markrlupton/rt1176-micromod-som/docs/floorplan_v1.png

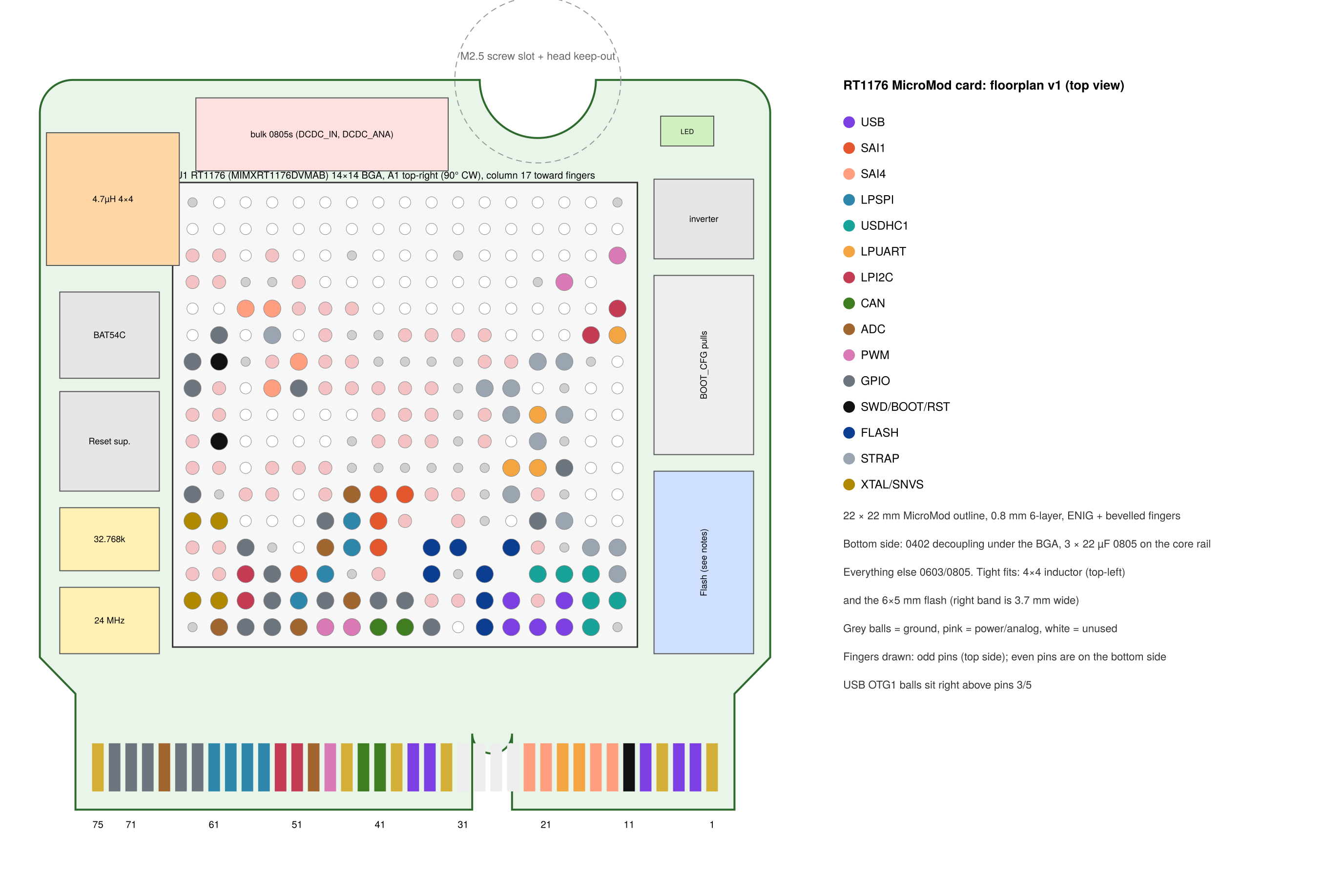
docs/floorplan_v1.png
