markrlupton/rt1176-micromod-som/docs/layout/b_cu.png

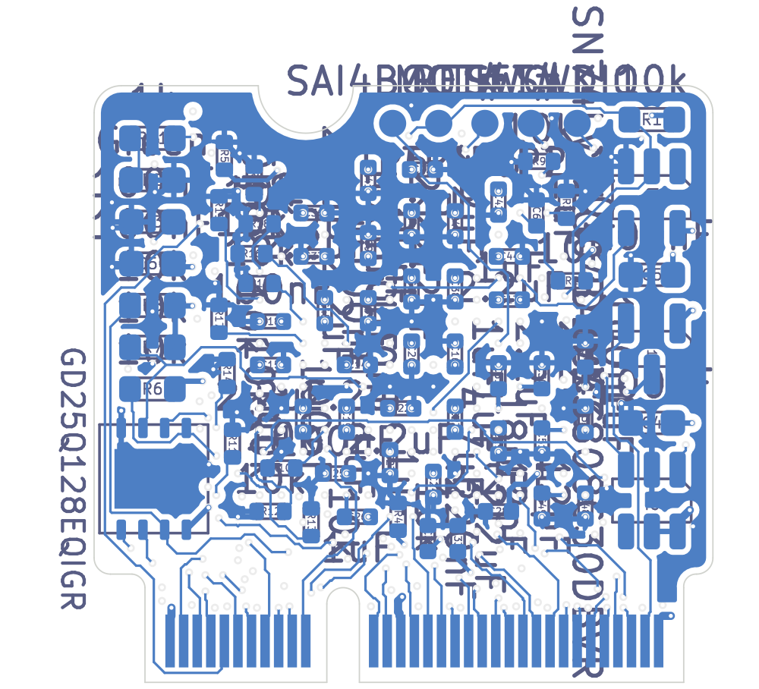
docs/layout/b_cu.png
