markrlupton/rt1176-micromod-som/docs/layout/f_cu.png

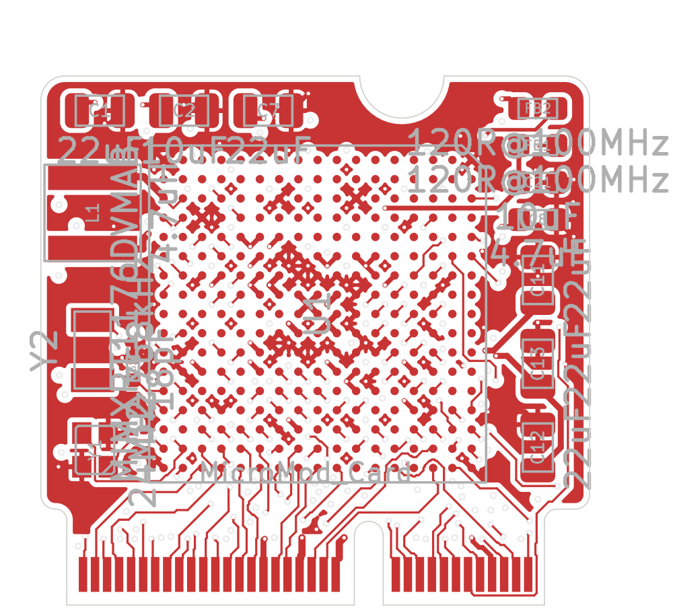
docs/layout/f_cu.png
