markrlupton/rt1176-micromod-som/docs/layout/in1_cu.png

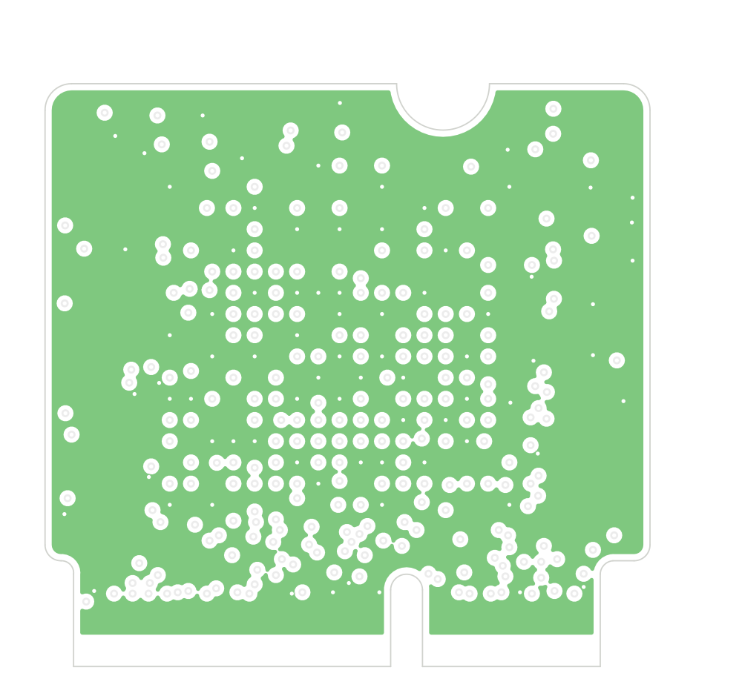
docs/layout/in1_cu.png
