markrlupton/rt1176-micromod-som/docs/layout/in2_cu.png

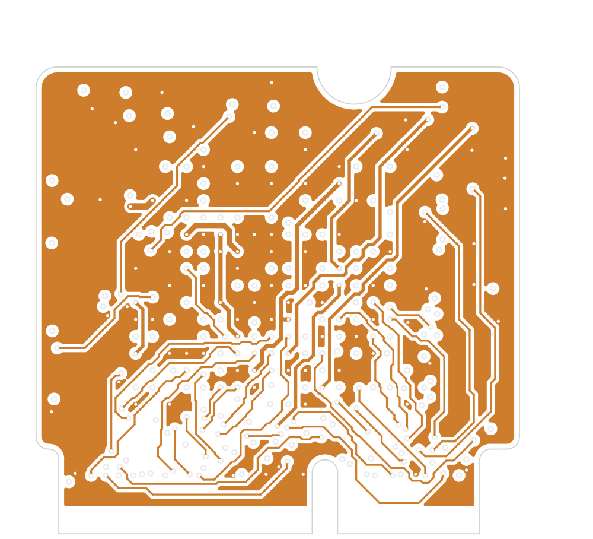
docs/layout/in2_cu.png
