markrlupton/rt1176-micromod-som/docs/layout/in3_cu.png

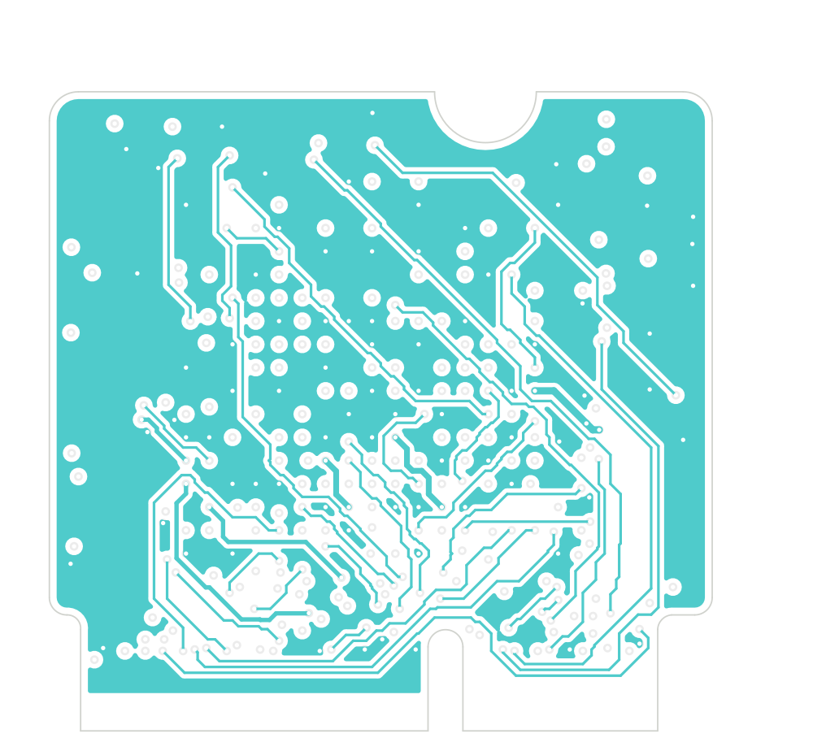
docs/layout/in3_cu.png
