markrlupton/rt1176-micromod-som/docs/layout/in4_cu.png

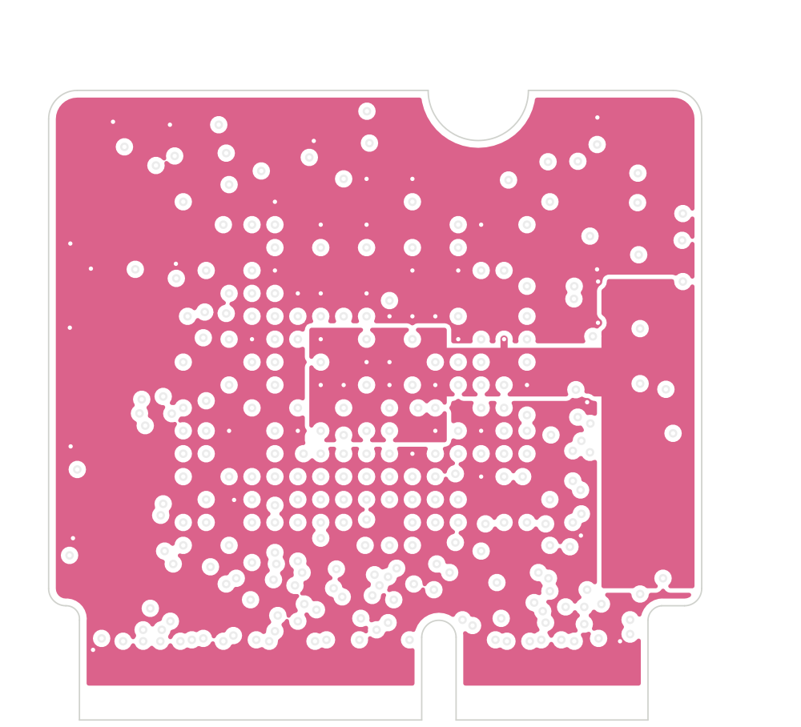
docs/layout/in4_cu.png
