markrlupton/rt1176-micromod-som/fab/bom-distributors.csv

Line | Qty per board | Qty for 5 boards | Manufacturer | Manufacturer Part Number | Description | Designators | Footprint | Side
1 | 5 | 35 | Samsung | CL21A226MAQNNNE | Cap ceramic 22 uF 25 V X5R 0805 | C1 C7 C11 C12 C13 | C_0805_2012Metric | top
2 | 1 | 15 | Samsung | CL21A106KAYNNNE | Cap ceramic 10 uF 25 V X5R 0805 | C2 | C_0805_2012Metric | top
3 | 4 | 30 | Yageo | CC0603KRX7R9BB104 | Cap ceramic 100 nF 50 V X7R 0603 | C3 C4 C5 C50 | C_0603_1608Metric | bottom
4 | 9 | 55 | Samsung | CL05A105KA5NQNC | Cap ceramic 1 uF 25 V X5R 0402 | C6 C16 C17 C23 C24 C26 C27 C32 C47 | C_0402_1005Metric | bottom
5 | 1 | 15 | Samsung | CL10A475KO8NNNC | Cap ceramic 4.7 uF 16 V X5R 0603 | C8 | C_0603_1608Metric | top
6 | 9 | 55 | Samsung | CL05B104KO5NNNC | Cap ceramic 100 nF 16 V X7R 0402 | C9 C10 C18 C19 C20 C25 C34 C45 C46 | C_0402_1005Metric | bottom
7 | 16 | 90 | Samsung | CL05A225MQ5NSNC | Cap ceramic 2.2 uF 6.3 V X5R 0402 | C14 C15 C22 C28 C30 C31 C33 C36 C37 C38 C39 C40 C41 C42 C43 C44 | C_0402_1005Metric | bottom
8 | 1 | 15 | Samsung | CL10A106KP8NNNC | Cap ceramic 10 uF 10 V X5R 0603 | C21 | C_0603_1608Metric | top
9 | 1 | 15 | Samsung | CL05A475MP5NRNC | Cap ceramic 4.7 uF 10 V X5R 0402 | C29 | C_0402_1005Metric | bottom
10 | 1 | 15 | Samsung | CL05B224KO5NNNC | Cap ceramic 220 nF 16 V X7R 0402 | C35 | C_0402_1005Metric | bottom
11 | 2 | 20 | Murata | GRM1555C1H120JA01D | Cap ceramic 12 pF 50 V C0G 0402 | C48 C49 | C_0402_1005Metric | bottom
12 | 2 | 20 | Murata | GRM1555C1H180JA01D | Cap ceramic 18 pF 50 V C0G 0402 | C51 C52 | C_0402_1005Metric | bottom/top
13 | 1 | 6 | Nexperia | BAT54C,215 | Schottky dual common cathode 30 V SOT-23 | D1 | SOT-23 | bottom
14 | 1 | 6 | Lite-On | LTST-C191KGKT | LED green 0603 | D2 | LED_0603_1608Metric | bottom
15 | 2 | 20 | Murata | BLM18PG121SN1D | Ferrite bead 120 R @ 100 MHz 2 A 0603 | FB1 FB2 | L_0603_1608Metric | top
16 | 1 | 6 | Sunlord | SWPA4030S4R7MT | Inductor 4.7 uH 2 A shielded 4x4x3 mm | L1 | L_Changjiang_FNR4030S | top
17 | 4 | 30 | Yageo | RC0603FR-0710KL | Res 10 k 1% 0603 | R1 R6 R7 R8 | R_0603_1608Metric | bottom
18 | 16 | 90 | Yageo | RC0402FR-0710KL | Res 10 k 1% 0402 | R2 R3 R4 R5 R9 R10 R11 R12 R13 R14 R15 R16 R17 R18 R19 R20 | R_0402_1005Metric | bottom
19 | 1 | 15 | Yageo | RC0603FR-071KL | Res 1 k 1% 0603 | R21 | R_0603_1608Metric | bottom
20 | 1 | 6 | NXP | MIMXRT1176DVMAB | i.MX RT1176 MCU, 1 GHz M7 + 400 MHz M4, 289 MAPBGA | U1 | MAPBGA_14x14mm_Layout17x17_P0.8mm | top
21 | 1 | 6 | Texas Instruments | TPS3808G30DBVR | Voltage supervisor 2.79 V, manual reset, SOT-23-6 | U2 | SOT-23-6 | bottom
22 | 1 | 6 | Texas Instruments | SN74LVC1G04DBVR | Single inverter SOT-23-5 | U3 | SOT-23-5 | bottom
23 | 1 | 6 | GigaDevice | GD25Q128EQIGR | QSPI NOR flash 128 Mbit (16 MB) USON-8 4x4 | U4 | USON-8-1EP_4x4mm_P0.8mm_EP2.3x3mm_GigaDevice | bottom
24 | 1 | 6 | Abracon | ABM11W-24.0000MHZ-8-D1X-T3 | Crystal 24 MHz 8 pF 10 ppm 2.0x1.6 mm | Y1 | Crystal_SMD_2016-4Pin_2.0x1.6mm | top
25 | 1 | 6 | Epson | Q13FC1350000400 | Crystal 32.768 kHz 12.5 pF FC-135 3.2x1.5 mm | Y2 | Crystal_SMD_3215-2Pin_3.2x1.5mm | top
