markrlupton/rt1176-micromod-som/docs/HAND_BUILD.md

# Hand build: RT1176 MicroMod card

Generated by `tools/fab.py` from the board and BOM. Placement drawings: `fab/assembly-top.pdf` and
`fab/assembly-bottom.pdf` (the bottom one is mirrored, so it matches the board turned over). The silkscreen carries
outlines and pin-1 marks only; use the drawings for designators.

## Order of work

**1. Top side first, on the hot plate.** The bottom is still bare, so the card sits flat on the plate.
- Paste the top with the hand-build stencil (`fab/stencil-hand/...-hand-F_Paste.gtp`): it has **no apertures for the BGA**.
- BGA: tacky flux only (e.g. Amtech NC-559), a thin even film on the pads. The balls bring their own solder.
- Place the BGA by the silkscreen outline and the pin-1 mark (A1 is at the top-right corner, beside the right-band caps).
- Place the other top parts (bulk caps, inductor, both crystals, ferrites, and C52, the one top-side 0402, beside Y2).
- Reflow: preheat to about 150 to 180 °C over 90 s, then up to 235 to 245 °C. Watch for the BGA to drop slightly and
  self-centre, hold about 30 s, then let it cool without touching it.

**2. Bottom side second, with low-temperature paste and hot air.**
- Paste: Sn42Bi57.6Ag0.4 (melts about 138 °C), bottom stencil `...-hand-B_Paste.gbp`.
- Rest the card BGA-down on two spacer strips (scrap FR4 or aluminium) on the plate, so nothing on top touches.
- Preheat at 100 to 120 °C. Reflow the bottom parts with hot air at about 200 to 220 °C, keeping the air moving and off
  the area right over the BGA as much as you can. The BGA's SAC305 balls melt at 217 °C, so they stay put.
- Bismuth solder is more brittle under shock and vibration. Fine for a bench card; a card for the car should be built
  with standard solder on both sides (JLC assembly or an oven).

**3. Inspect and clean.** Flux off with IPA. Look along the BGA edges with a loupe for even collapse and no bridges
(you can't see the inner balls; the electrical checks below are the test).

## First power-up

1. Before power: ohmmeter, +3V3 to GND (fingers 2/74 to any GND finger). Expect it to climb slowly (caps charging),
   not a dead short.
2. Bench supply 3.3 V, current limit about 100 mA, into the 3.3 V fingers (carrier or clip leads).
3. Current should settle to tens of mA. If it sits at the limit, power off and look for a short.
4. Rails: DCDC_ANA about 1.8 V (C21 / FB1), DCDC_DIG about 1.0 to 1.1 V (C11, C12, C13).
5. 24 MHz: scope probe (10x) on Y1 pad 3 (XTALO) should show a sine of a few hundred mV.
6. SWD: the test pads on the bottom edge (TP1 SWDIO, TP2 SWCLK, TP3 RESET#). Connect a debugger and read the chip ID.
7. Serial downloader: hold BOOT# (TP4, or MicroMod pin 11 on the carrier) low through reset; the chip enumerates over USB1 as
   an NXP SDP/HID device. Program the flash from there (MCUXpresso Secure Provisioning or blhost).

## Parts, top side

| Ref | Part | Footprint | Qty |
|---|---|---|---|
| C1, C7, C11, C12, C13 | 22uF | C (0805) | 5 |
| C2 | 10uF | C (0805) | 1 |
| C8 | 4.7uF | C (0603) | 1 |
| C21 | 10uF | C (0603) | 1 |
| C52 | 18pF | C (0402) | 1 |
| FB1, FB2 | 120R@100MHz | L (0603) | 2 |
| L1 | 4.7uH | L (Changjiang) | 1 |
| U1 | MIMXRT1176DVMAB | MAPBGA_14x14mm_Layout17x17_P0.8mm  | 1 |
| Y1 | 24MHz | Crystal_SMD_2016-4Pin_2.0x1.6mm  | 1 |
| Y2 | 32.768kHz | Crystal_SMD_3215-2Pin_3.2x1.5mm  | 1 |

## Parts, bottom side

| Ref | Part | Footprint | Qty |
|---|---|---|---|
| C3, C4, C5, C50 | 100nF | C (0603) | 4 |
| C6, C16, C17, C23, C24, C26, C27, C32, C47 | 1uF | C (0402) | 9 |
| C9, C10, C18, C19, C20, C25, C34, C45, C46 | 100nF | C (0402) | 9 |
| C14, C15, C22, C28, C30, C31, C33, C36, C37, C38, C39, C40, C41, C42, C43, C44 | 2.2uF | C (0402) | 16 |
| C29 | 4.7uF | C (0402) | 1 |
| C35 | 220nF | C (0402) | 1 |
| C48, C49 | 12pF | C (0402) | 2 |
| C51 | 18pF | C (0402) | 1 |
| D1 | BAT54C | SOT-23  | 1 |
| D2 | Green | LED (0603) | 1 |
| R1, R6, R7, R8 | 10k | R (0603) | 4 |
| R2, R3, R4, R5, R9, R10, R11, R12, R13, R14, R15, R16, R17, R18, R19, R20 | 10k | R (0402) | 16 |
| R21 | 1k | R (0603) | 1 |
| U2 | TPS3808G30DBVR | SOT-23-6  | 1 |
| U3 | SN74LVC1G04DBVR | SOT-23-5  | 1 |
| U4 | GD25Q128EQIGR | USON-8-1EP_4x4mm_P0.8mm_EP2.3x3mm_GigaDevice  | 1 |
