markrlupton/rt1176-micromod-som/docs/schematic.pdf

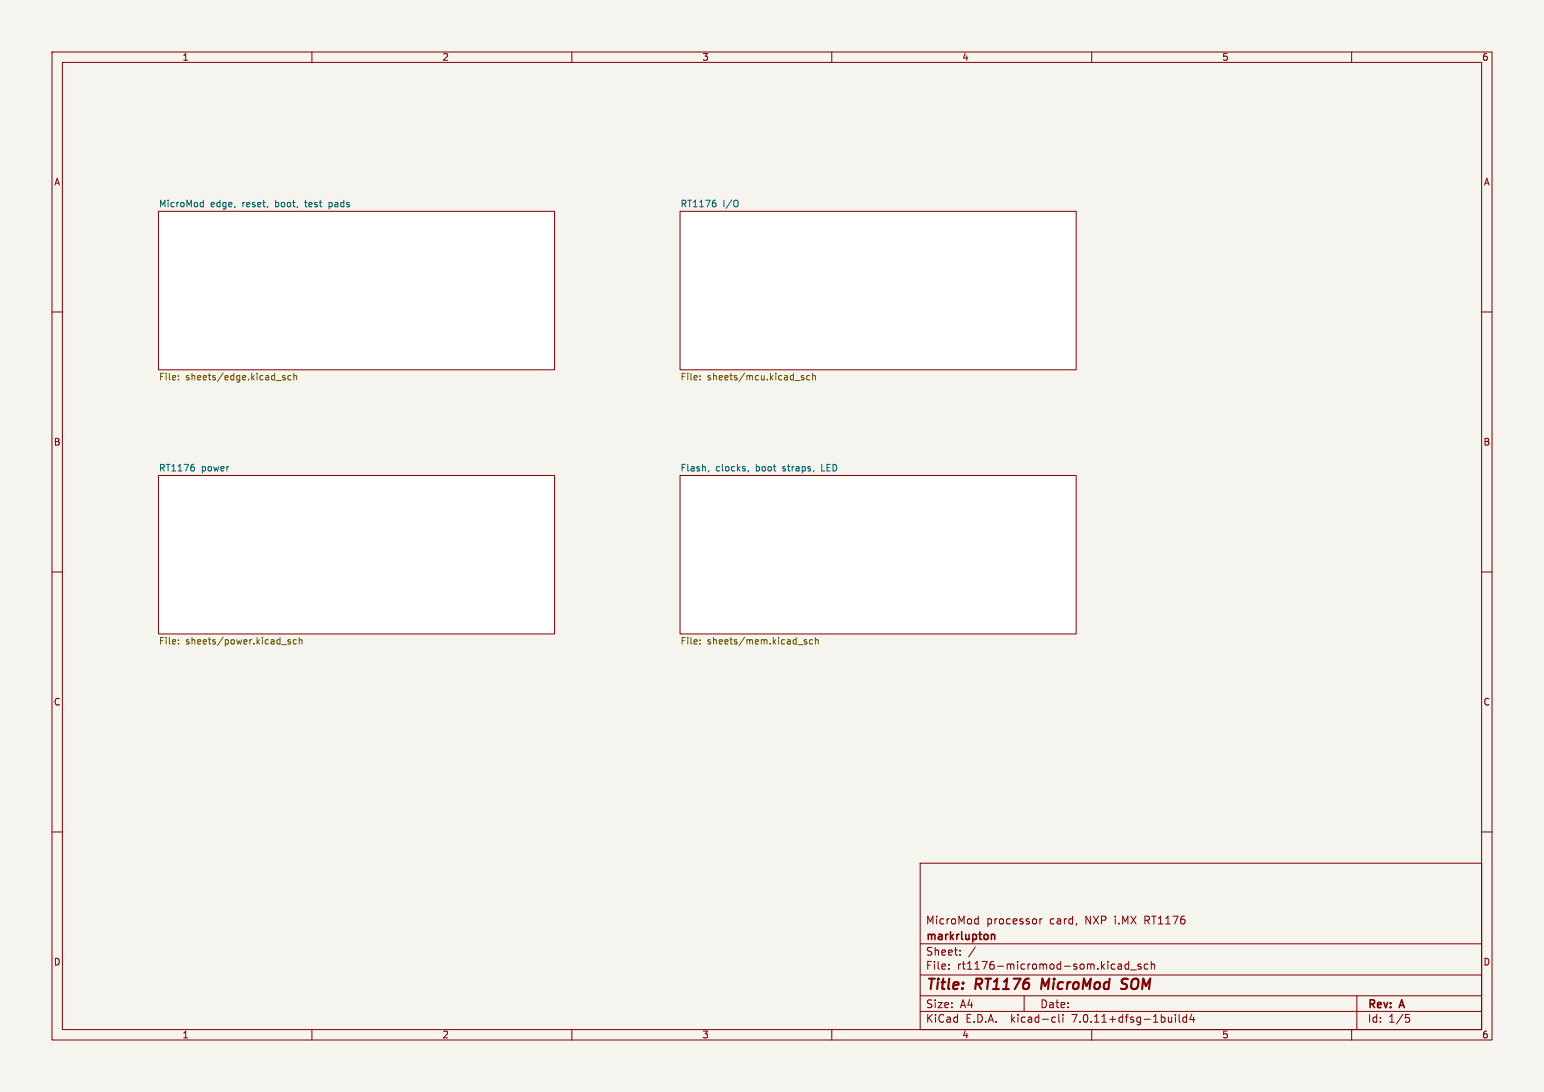
[picture p8: page 1]

Id: 1/5 Title: RT1176 MicroMod SOM

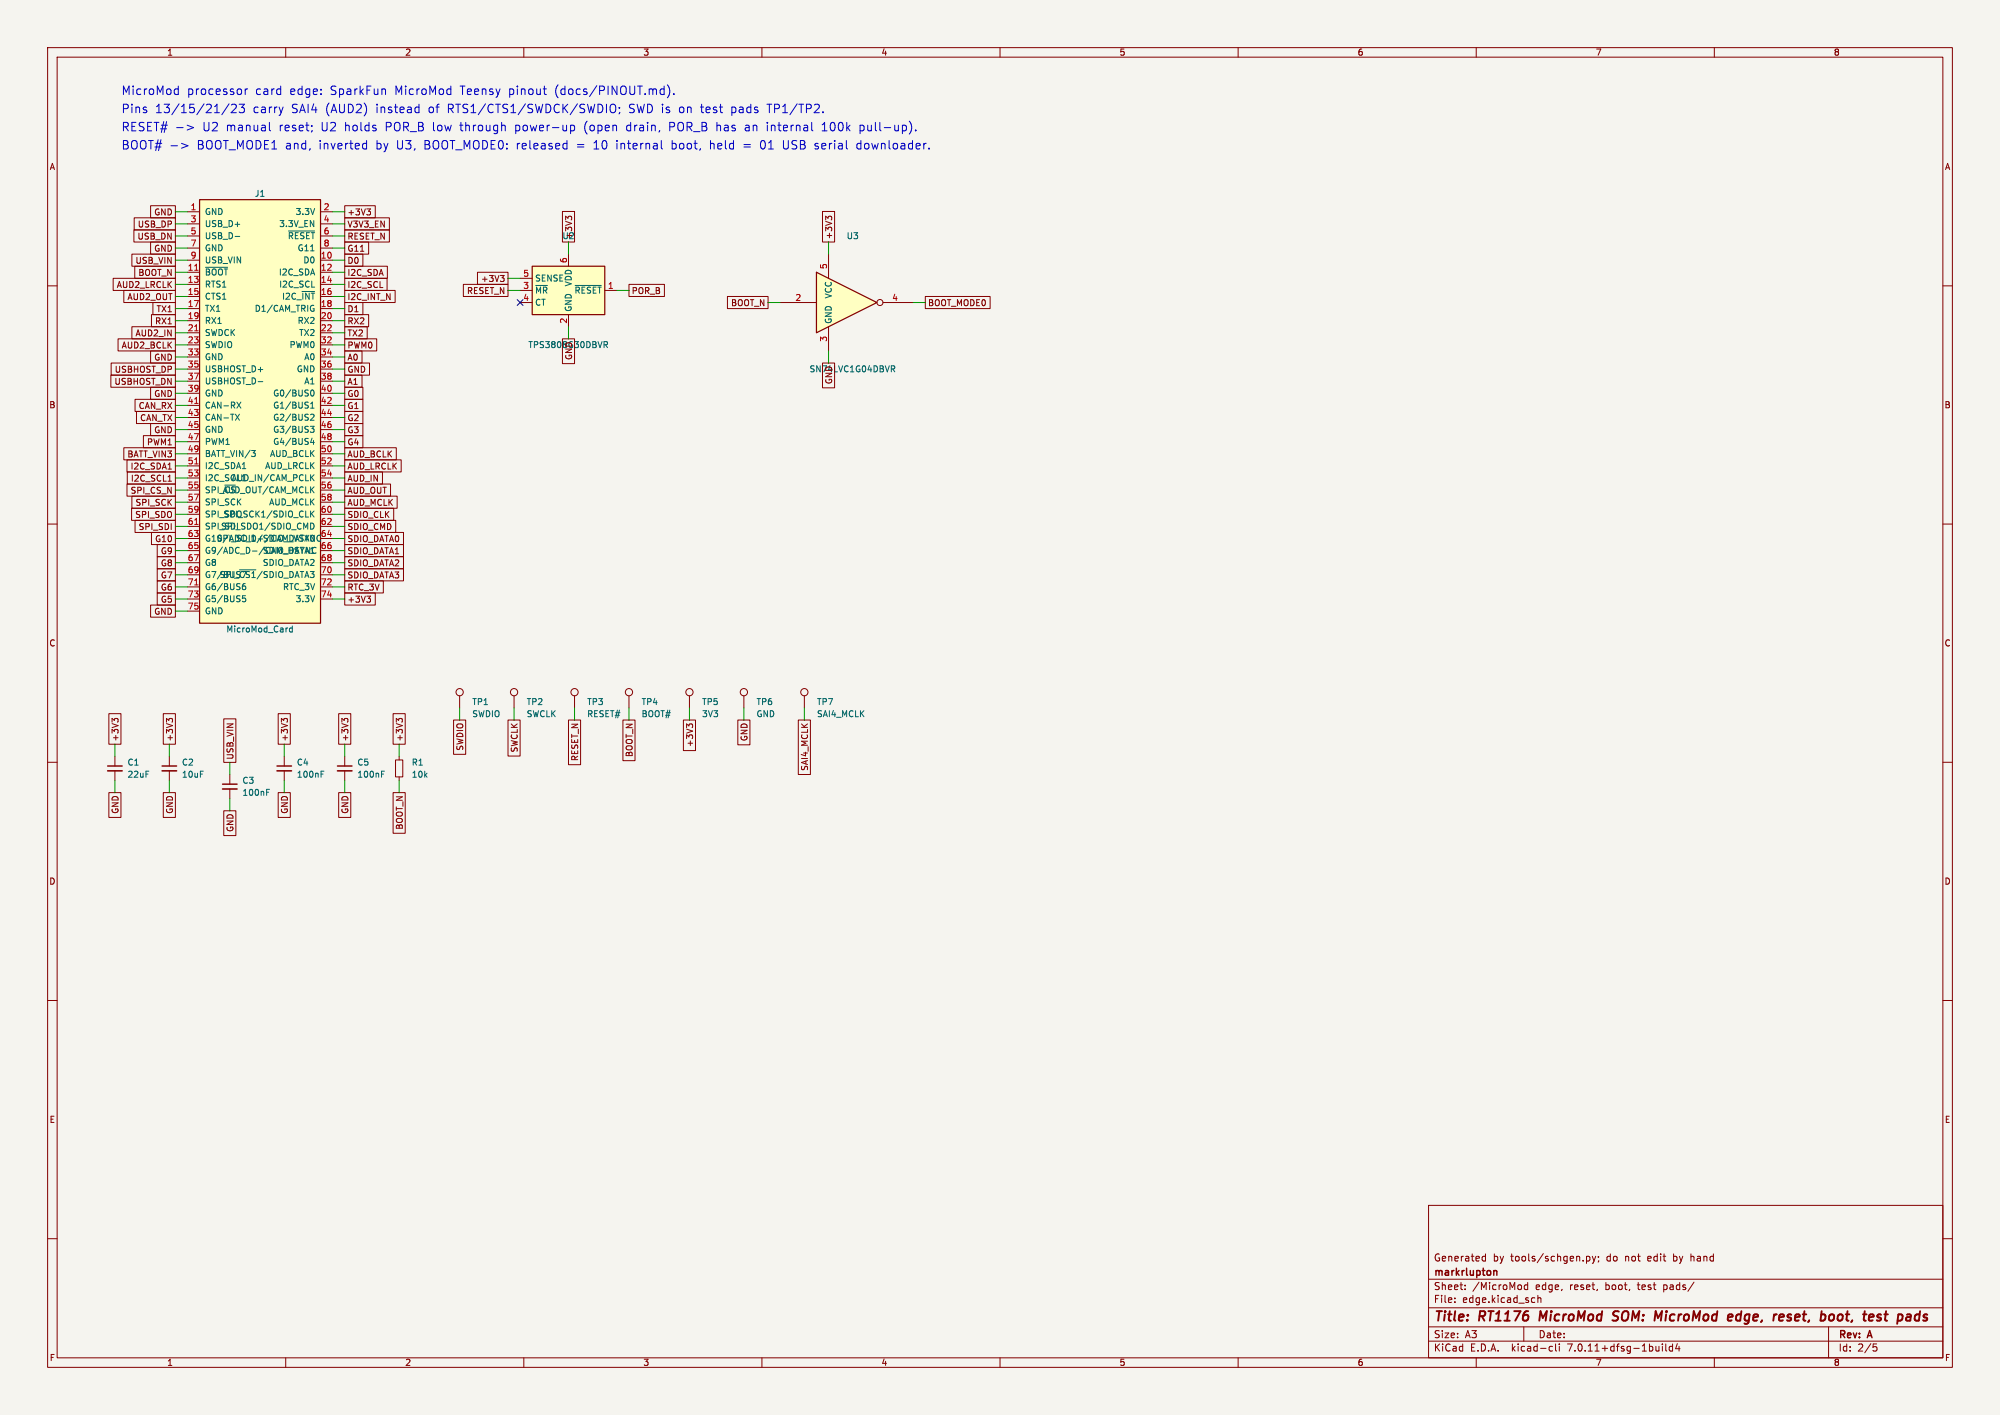
[picture p9: page 2]

2 ~{MR} 3 CT 4 SENSE 5 VDD

Id: 2/5 Title: RT1176 MicroMod SOM: MicroMod edge, reset, boot, test pads

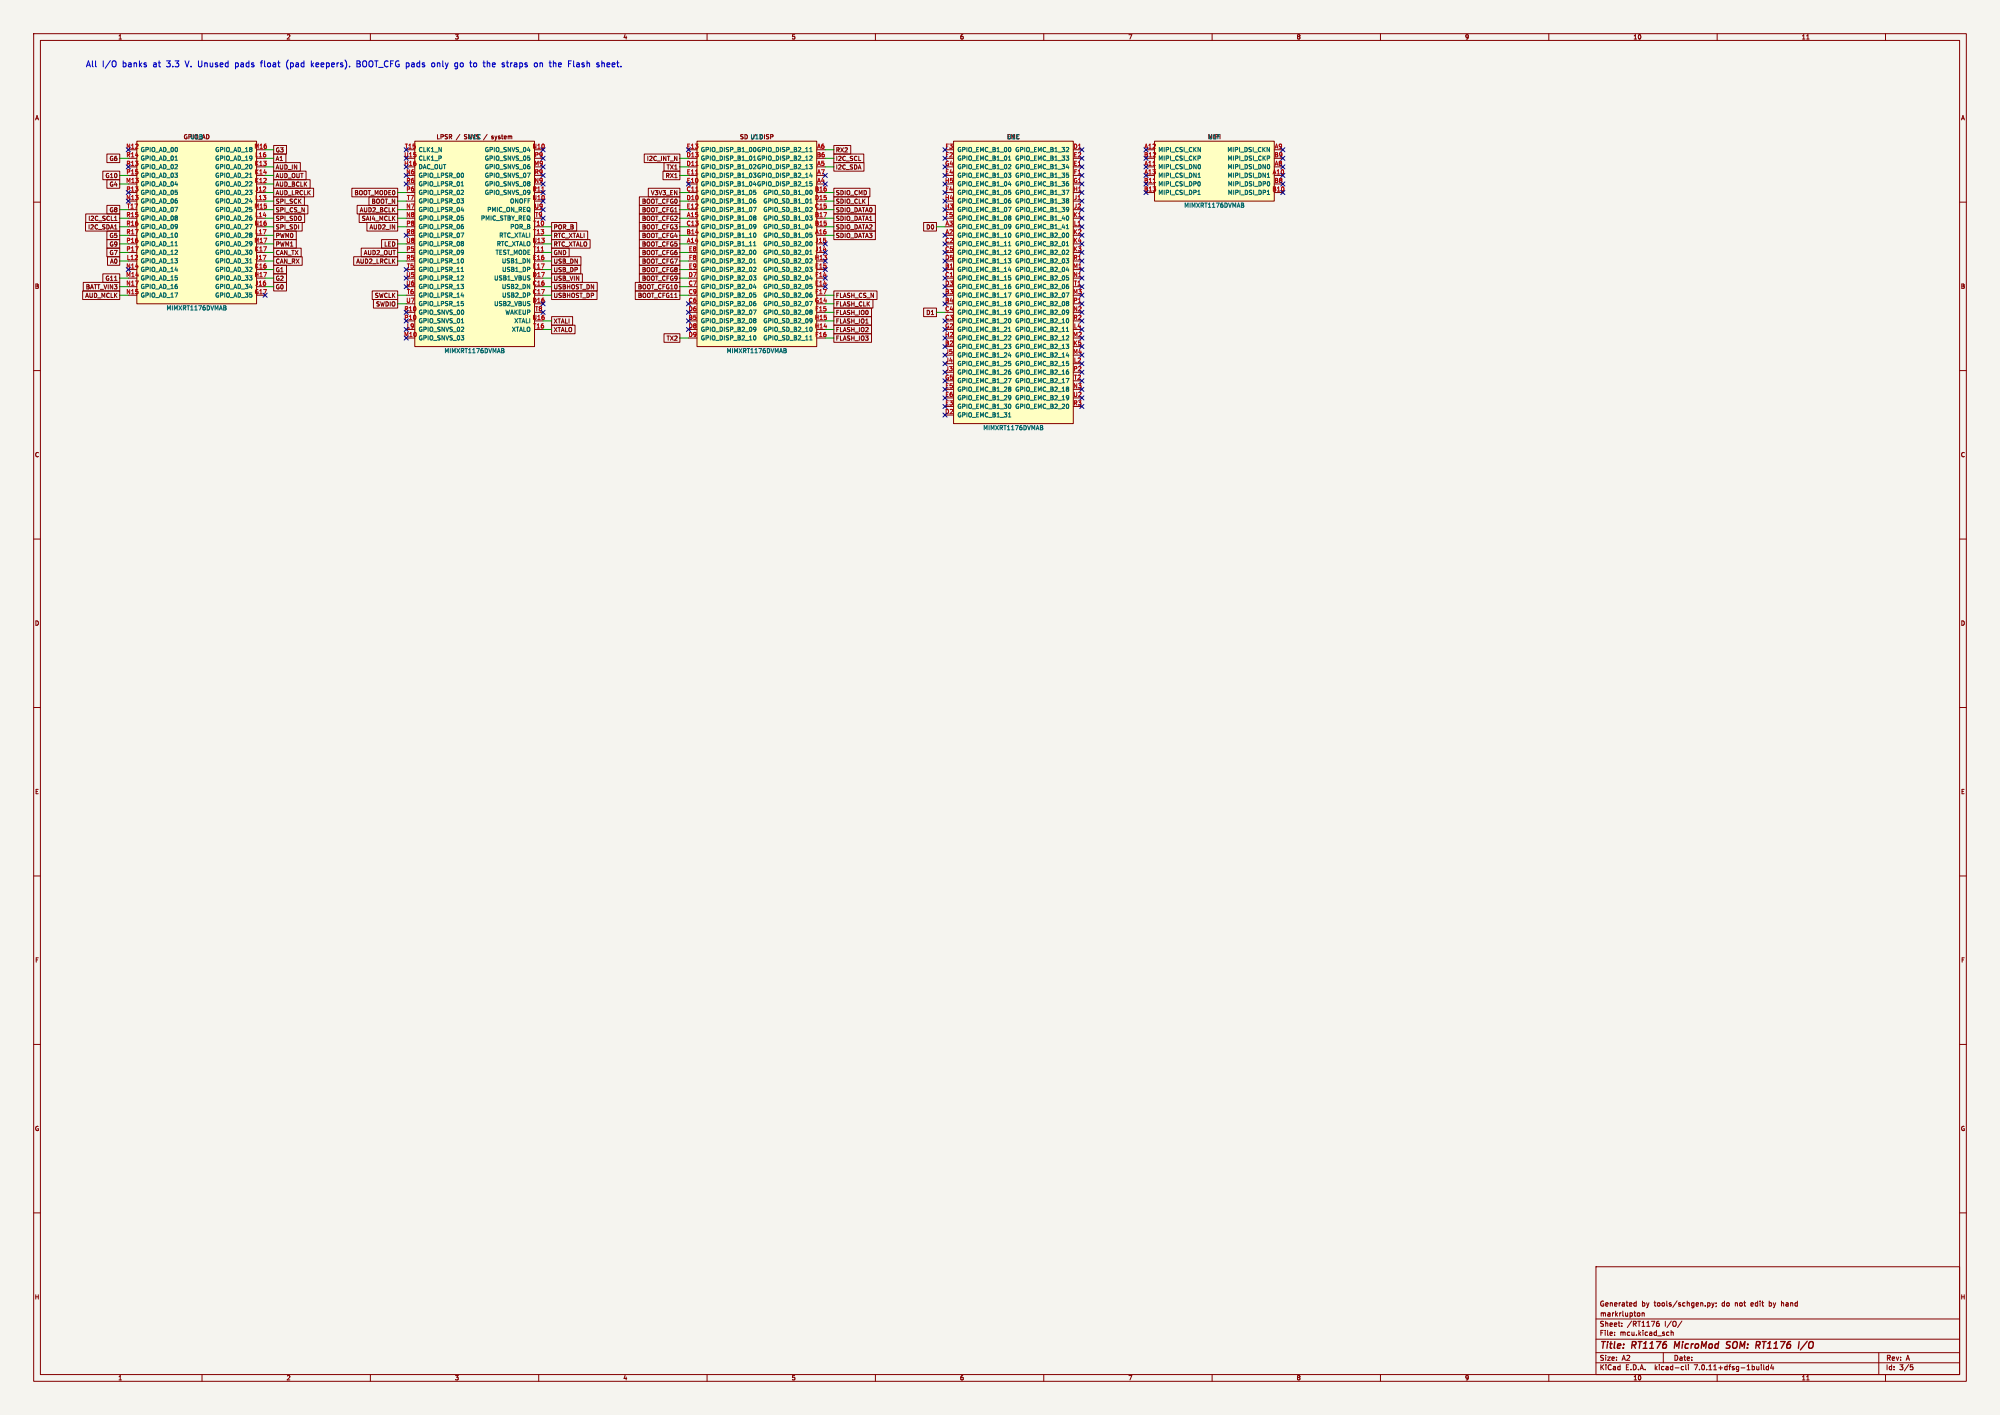
[picture p10: page 3]

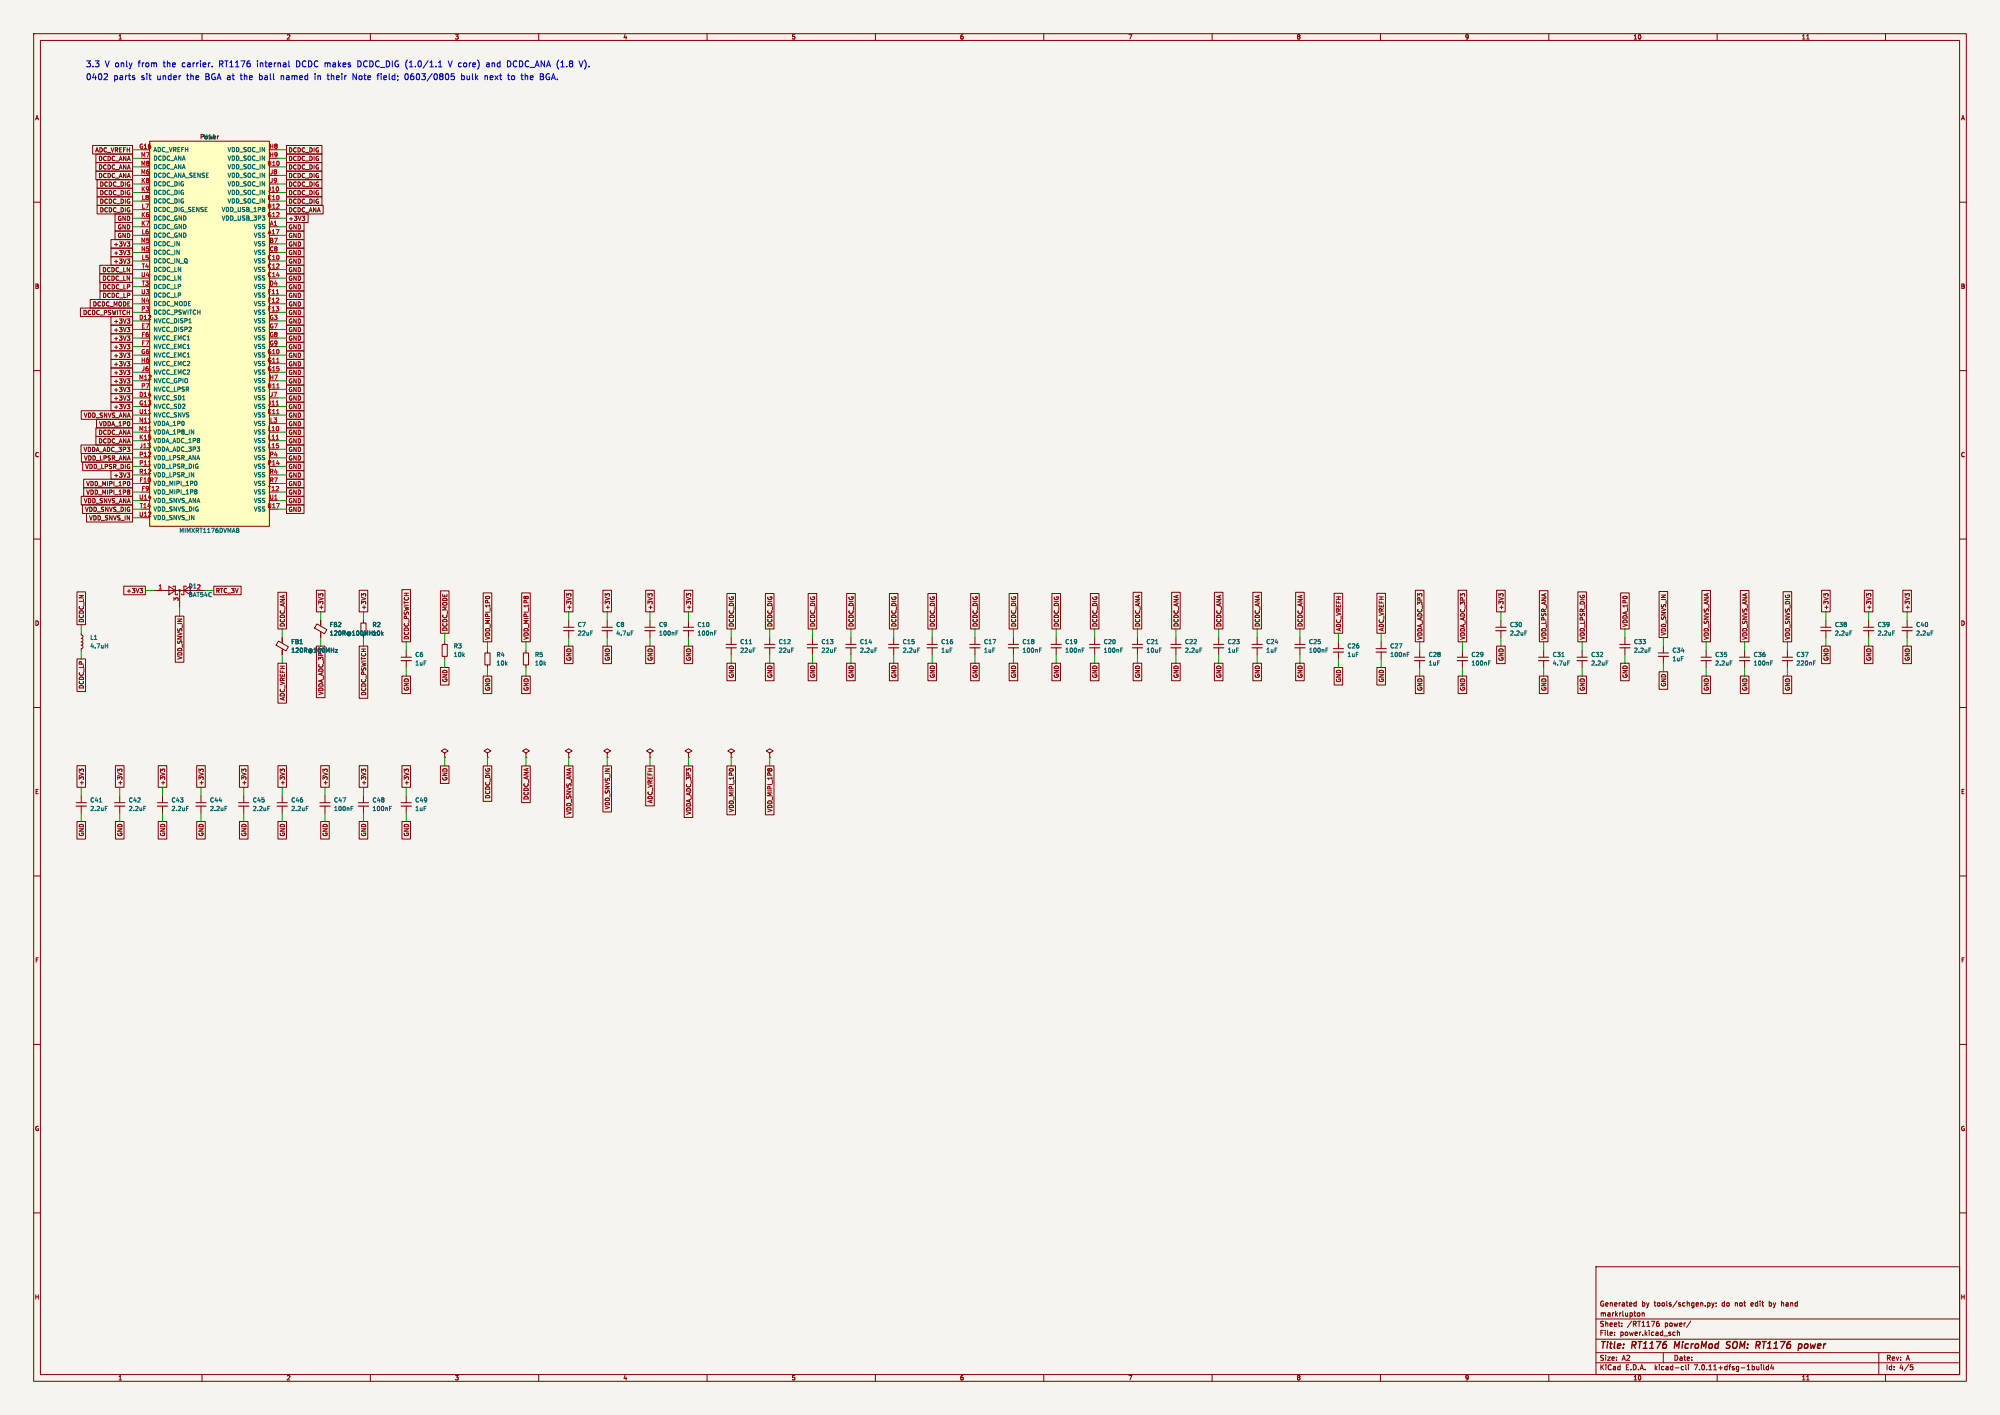
[picture p11: page 4]

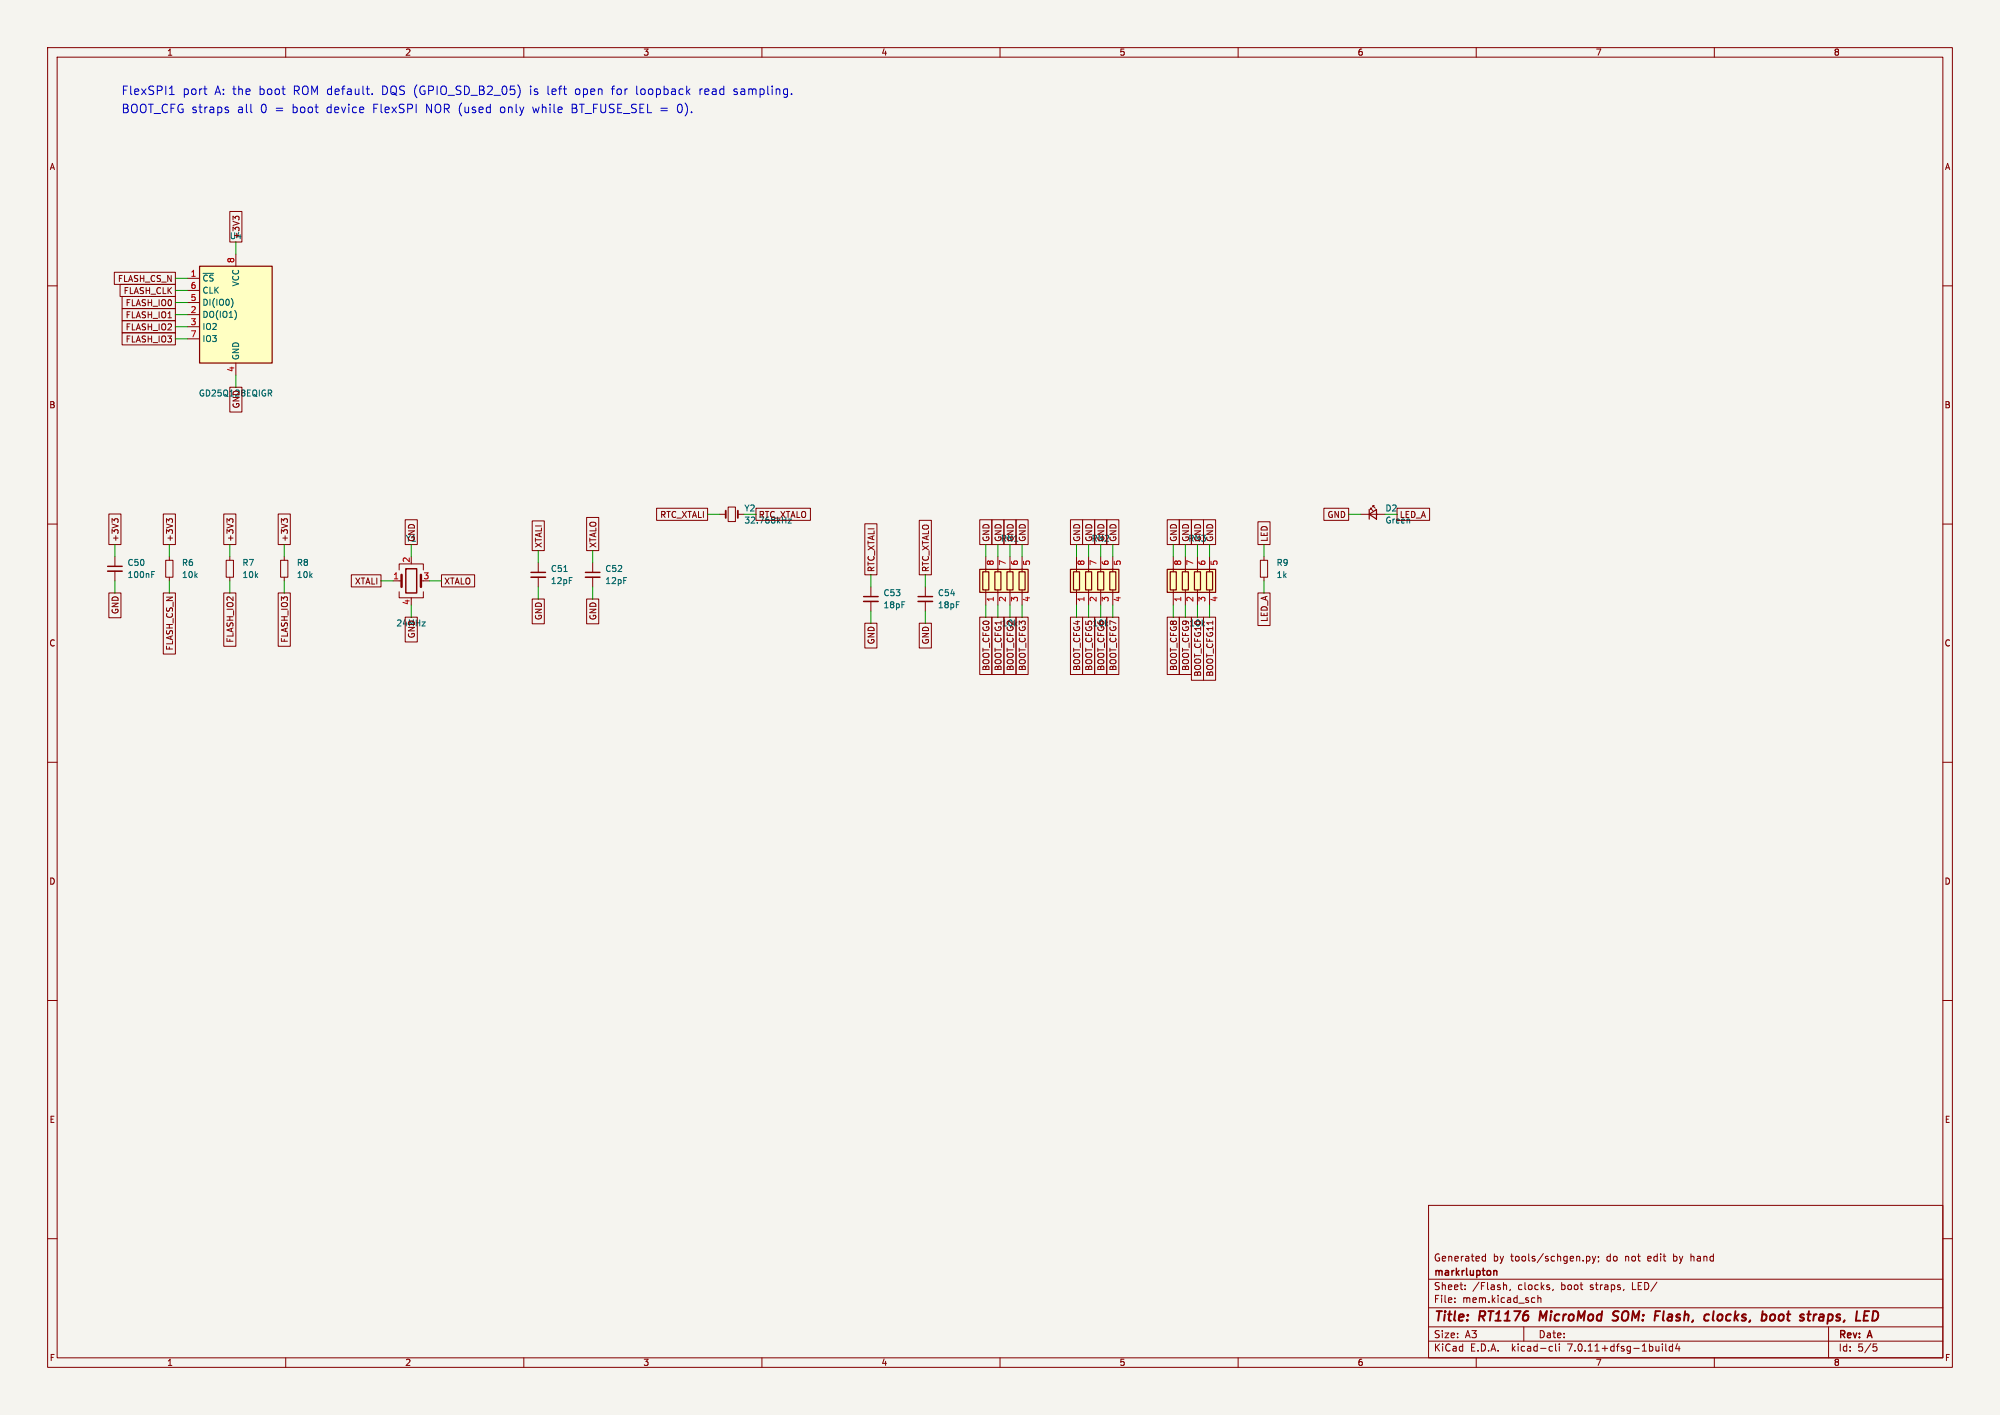
[picture p12: page 5]

BOOT_CFG straps all 0 = boot device FlexSPI NOR (used only while BT_FUSE_SEL = 0).

Id: 5/5 Title: RT1176 MicroMod SOM: Flash, clocks, boot straps, LED
