markrlupton/rt1176-micromod-som/fab/assembly-bottom.pdf

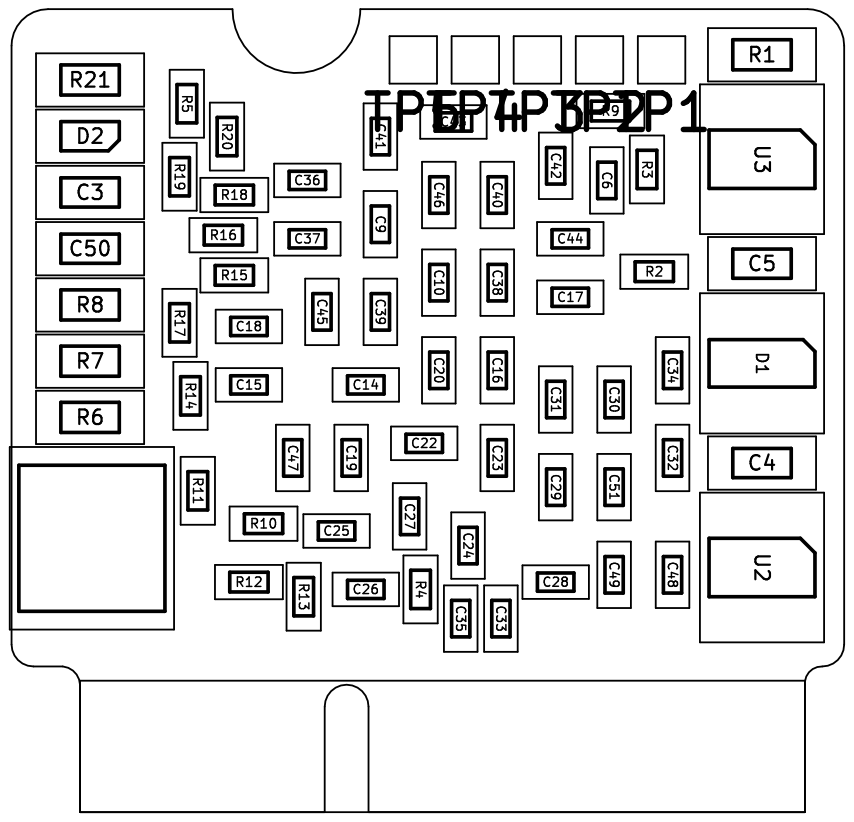
[picture p13: page 1]
