markrlupton/rt1176-micromod-som/fab/assembly-top.pdf

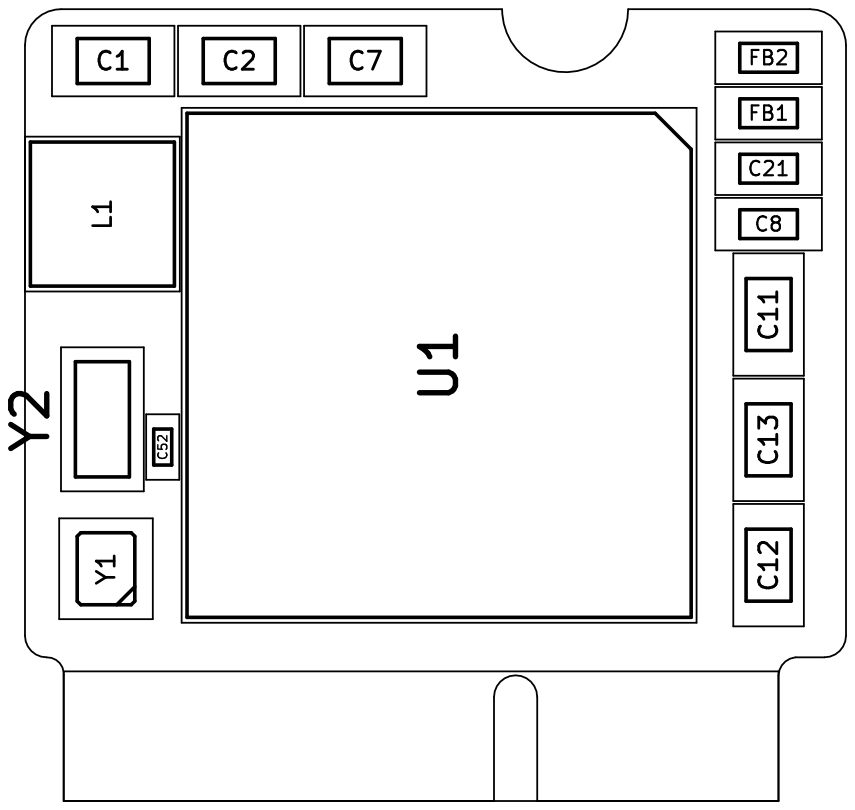
[picture p14: page 1]
