markrlupton/rt1176-micromod-som/rt1176-micromod-som.kicad_pcb

## KiCad design rt1176-micromod-som.kicad_pcb (2026-11-14)

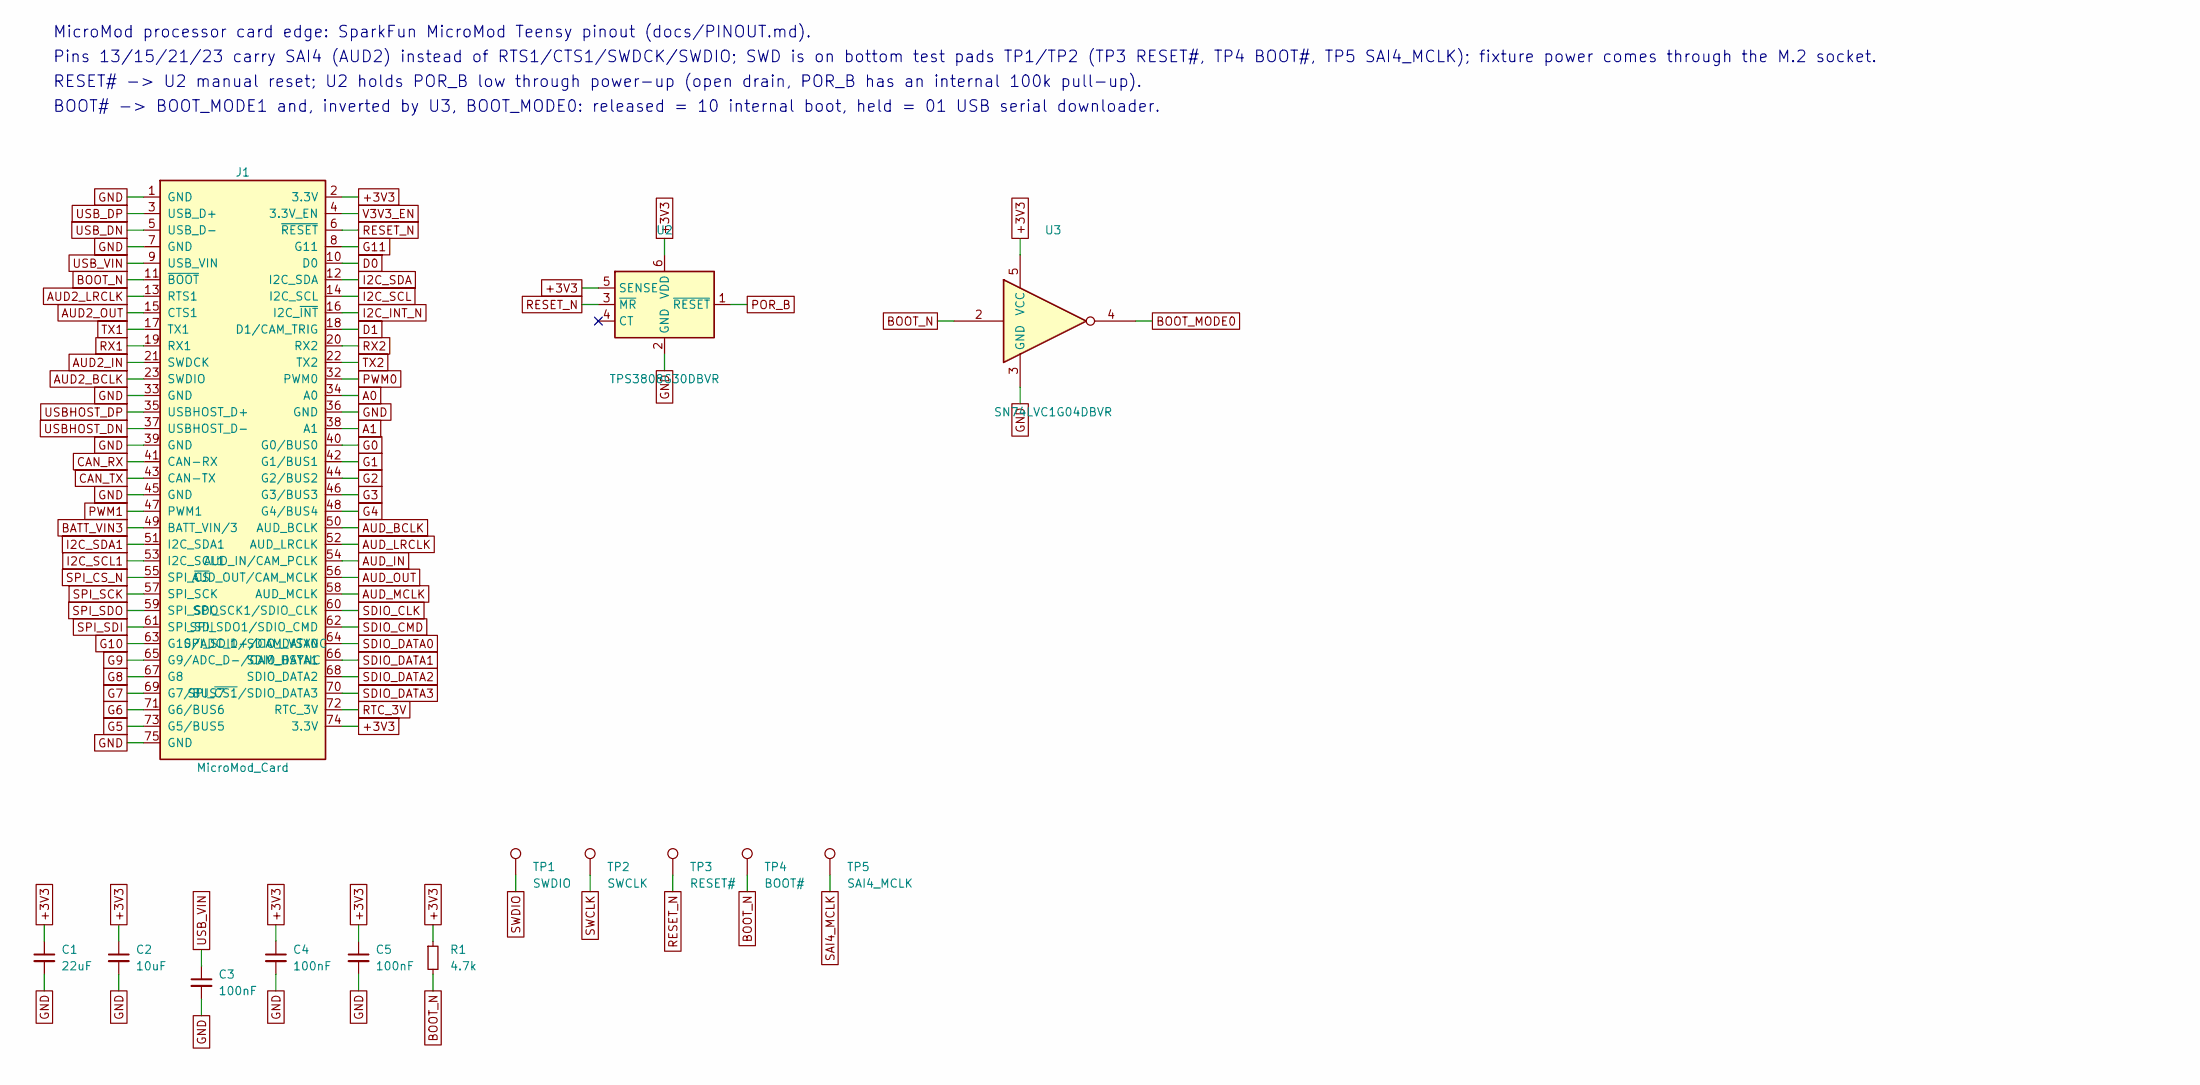
[picture p15: schematic edge.kicad_sch, RT1176 MicroMod SOM: MicroMod edge, reset, boot, test pads]

Parts:
C1: 22uF; C_0805_2012Metric
C2: 10uF; C_0805_2012Metric
C3, C4, C5: 100nF; C_0603_1608Metric
J1: MicroMod_Card; MicroMod_Card_Edge
R1: 4.7k; R_0603_1608Metric
TP1: SWDIO; TestPoint_Pad_D1.0mm
TP2: SWCLK; TestPoint_Pad_D1.0mm
TP3: RESET#; TestPoint_Pad_D1.0mm
TP4: BOOT#; TestPoint_Pad_D1.0mm
TP5: SAI4_MCLK; TestPoint_Pad_D1.0mm
U2: TPS3808G30DBVR; SOT-23-6; MPN TPS3808G30DBVR; LCSC C189211
U3: SN74LVC1G04DBVR; SOT-23-5; MPN SN74LVC1G04DBVR; LCSC C7827

Connections:
+3V3: C1.1, C2.1, C4.1, C5.1, J1.2 (3.3V), J1.74 (3.3V), R1.1, U2.5 (SENSE), U2.6 (VDD), U3.5 (VCC); also elsewhere on the board
A0: J1.34 (A0); also elsewhere on the board
A1: J1.38 (A1); also elsewhere on the board
AUD2_BCLK: J1.23 (SWDIO); also elsewhere on the board
AUD2_IN: J1.21 (SWDCK); also elsewhere on the board
AUD2_LRCLK: J1.13 (RTS1); also elsewhere on the board
AUD2_OUT: J1.15 (CTS1); also elsewhere on the board
AUD_BCLK: J1.50 (AUD_BCLK); also elsewhere on the board
AUD_IN: J1.54 (AUD_IN/CAM_PCLK); also elsewhere on the board
AUD_LRCLK: J1.52 (AUD_LRCLK); also elsewhere on the board
AUD_MCLK: J1.58 (AUD_MCLK); also elsewhere on the board
AUD_OUT: J1.56 (AUD_OUT/CAM_MCLK); also elsewhere on the board
BATT_VIN3: J1.49 (BATT_VIN/3); also elsewhere on the board
BOOT_MODE0: U3.4; also elsewhere on the board
BOOT_N: J1.11 (~BOOT), R1.2, TP4.1, U3.2; also elsewhere on the board
CAN_RX: J1.41 (CAN-RX); also elsewhere on the board
CAN_TX: J1.43 (CAN-TX); also elsewhere on the board
D0: J1.10 (D0); also elsewhere on the board
D1: J1.18 (D1/CAM_TRIG); also elsewhere on the board
G0: J1.40 (G0/BUS0); also elsewhere on the board
G1: J1.42 (G1/BUS1); also elsewhere on the board
G2: J1.44 (G2/BUS2); also elsewhere on the board
G3: J1.46 (G3/BUS3); also elsewhere on the board
G4: J1.48 (G4/BUS4); also elsewhere on the board
G5: J1.73 (G5/BUS5); also elsewhere on the board
G6: J1.71 (G6/BUS6); also elsewhere on the board
G7: J1.69 (G7/BUS7); also elsewhere on the board
G8: J1.67 (G8); also elsewhere on the board
G9: J1.65 (G9/ADC_D-/CAM_HSYNC); also elsewhere on the board
G10: J1.63 (G10/ADC_D+/CAM_VSYNC); also elsewhere on the board
G11: J1.8 (G11); also elsewhere on the board
GND: C1.2, C2.2, C3.2, C4.2, C5.2, J1.1 (GND), J1.7 (GND), J1.33 (GND), J1.36 (GND), J1.39 (GND), J1.45 (GND), J1.75 (GND), U2.2 (GND), U3.3 (GND); also elsewhere on the board
I2C_INT_N: J1.16 (I2C_~INT); also elsewhere on the board
I2C_SCL: J1.14 (I2C_SCL); also elsewhere on the board
I2C_SCL1: J1.53 (I2C_SCL1); also elsewhere on the board
I2C_SDA: J1.12 (I2C_SDA); also elsewhere on the board
I2C_SDA1: J1.51 (I2C_SDA1); also elsewhere on the board
POR_B: U2.1 (~RESET); also elsewhere on the board
PWM0: J1.32 (PWM0); also elsewhere on the board
PWM1: J1.47 (PWM1); also elsewhere on the board
RESET_N: J1.6 (~RESET), TP3.1, U2.3 (~MR)
RTC_3V: J1.72 (RTC_3V); also elsewhere on the board
RX1: J1.19 (RX1); also elsewhere on the board
RX2: J1.20 (RX2); also elsewhere on the board
SAI4_MCLK: TP5.1; also elsewhere on the board
SDIO_CLK: J1.60 (SPI_SCK1/SDIO_CLK); also elsewhere on the board
SDIO_CMD: J1.62 (SPI_SDO1/SDIO_CMD); also elsewhere on the board
SDIO_DATA0: J1.64 (SPI_SDI1/SDIO_DATA0); also elsewhere on the board
SDIO_DATA1: J1.66 (SDIO_DATA1); also elsewhere on the board
SDIO_DATA2: J1.68 (SDIO_DATA2); also elsewhere on the board
SDIO_DATA3: J1.70 (SPI_~CS1/SDIO_DATA3); also elsewhere on the board
SPI_CS_N: J1.55 (SPI_~CS); also elsewhere on the board
SPI_SCK: J1.57 (SPI_SCK); also elsewhere on the board
SPI_SDI: J1.61 (SPI_SDI); also elsewhere on the board
SPI_SDO: J1.59 (SPI_SDO); also elsewhere on the board
SWCLK: TP2.1; also elsewhere on the board
SWDIO: TP1.1; also elsewhere on the board
TX1: J1.17 (TX1); also elsewhere on the board
TX2: J1.22 (TX2); also elsewhere on the board
USBHOST_DN: J1.37 (USBHOST_D-); also elsewhere on the board
USBHOST_DP: J1.35 (USBHOST_D+); also elsewhere on the board
USB_DN: J1.5 (USB_D-); also elsewhere on the board
USB_DP: J1.3 (USB_D+); also elsewhere on the board
USB_VIN: C3.1, J1.9 (USB_VIN); also elsewhere on the board
V3V3_EN: J1.4 (3.3V_EN); also elsewhere on the board

Notes on the sheet:
MicroMod processor card edge: SparkFun MicroMod Teensy pinout (docs/PINOUT.md).
Pins 13/15/21/23 carry SAI4 (AUD2) instead of RTS1/CTS1/SWDCK/SWDIO; SWD is on bottom test pads TP1/TP2 (TP3 RESET#, TP4 BOOT#, TP5 SAI4_MCLK); fixture power comes through the M.2 socket.
RESET# -> U2 manual reset; U2 holds POR_B low through power-up (open drain, POR_B has an internal 100k pull-up).
BOOT# -> BOOT_MODE1 and, inverted by U3, BOOT_MODE0: released = 10 internal boot, held = 01 USB serial downloader.

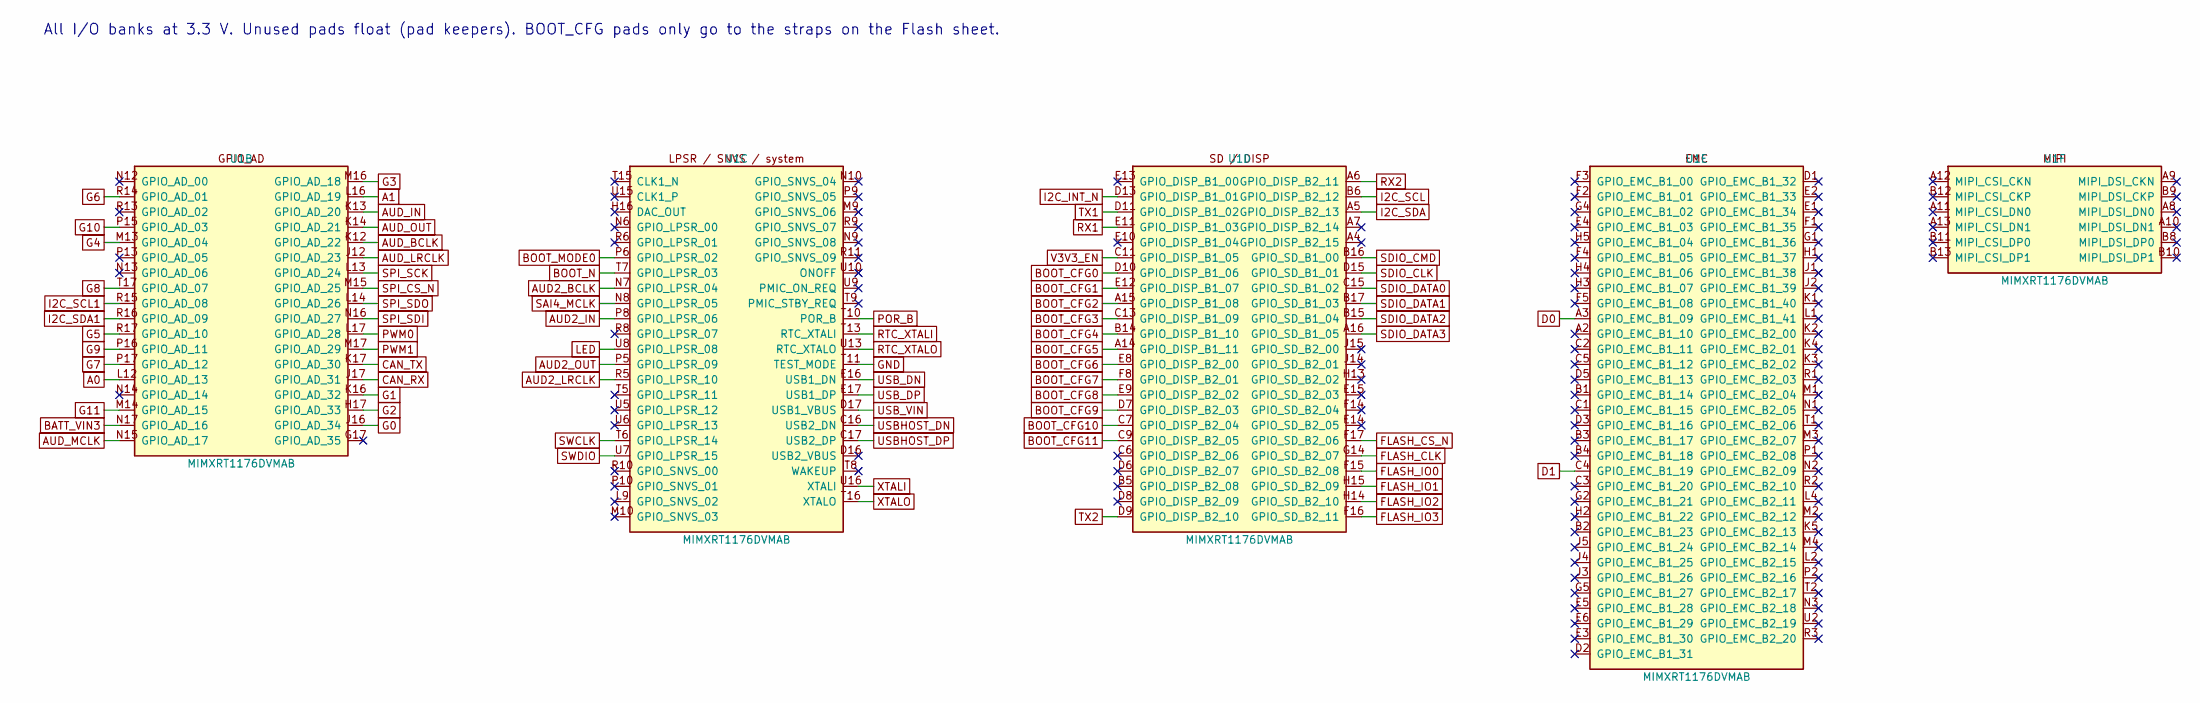
[picture p16: schematic mcu.kicad_sch, RT1176 MicroMod SOM: RT1176 I/O]

Parts:
U1: MIMXRT1176DVMAB; MAPBGA_14x14mm_Layout17x17_P0.8mm; MPN MIMXRT1176DVMAB

Connections:
A0: U1.L12 (GPIO_AD_13); also elsewhere on the board
A1: U1.L16 (GPIO_AD_19); also elsewhere on the board
AUD2_BCLK: U1.N7 (GPIO_LPSR_04); also elsewhere on the board
AUD2_IN: U1.P8 (GPIO_LPSR_06); also elsewhere on the board
AUD2_LRCLK: U1.R5 (GPIO_LPSR_10); also elsewhere on the board
AUD2_OUT: U1.P5 (GPIO_LPSR_09); also elsewhere on the board
AUD_BCLK: U1.K12 (GPIO_AD_22); also elsewhere on the board
AUD_IN: U1.K13 (GPIO_AD_20); also elsewhere on the board
AUD_LRCLK: U1.J12 (GPIO_AD_23); also elsewhere on the board
AUD_MCLK: U1.N15 (GPIO_AD_17); also elsewhere on the board
AUD_OUT: U1.K14 (GPIO_AD_21); also elsewhere on the board
BATT_VIN3: U1.N17 (GPIO_AD_16); also elsewhere on the board
BOOT_CFG0: U1.D10 (GPIO_DISP_B1_06); also elsewhere on the board
BOOT_CFG1: U1.E12 (GPIO_DISP_B1_07); also elsewhere on the board
BOOT_CFG2: U1.A15 (GPIO_DISP_B1_08); also elsewhere on the board
BOOT_CFG3: U1.C13 (GPIO_DISP_B1_09); also elsewhere on the board
BOOT_CFG4: U1.B14 (GPIO_DISP_B1_10); also elsewhere on the board
BOOT_CFG5: U1.A14 (GPIO_DISP_B1_11); also elsewhere on the board
BOOT_CFG6: U1.E8 (GPIO_DISP_B2_00); also elsewhere on the board
BOOT_CFG7: U1.F8 (GPIO_DISP_B2_01); also elsewhere on the board
BOOT_CFG8: U1.E9 (GPIO_DISP_B2_02); also elsewhere on the board
BOOT_CFG9: U1.D7 (GPIO_DISP_B2_03); also elsewhere on the board
BOOT_CFG10: U1.C7 (GPIO_DISP_B2_04); also elsewhere on the board
BOOT_CFG11: U1.C9 (GPIO_DISP_B2_05); also elsewhere on the board
BOOT_MODE0: U1.P6 (GPIO_LPSR_02); also elsewhere on the board
BOOT_N: U1.T7 (GPIO_LPSR_03); also elsewhere on the board
CAN_RX: U1.J17 (GPIO_AD_31); also elsewhere on the board
CAN_TX: U1.K17 (GPIO_AD_30); also elsewhere on the board
D0: U1.A3 (GPIO_EMC_B1_09); also elsewhere on the board
D1: U1.C4 (GPIO_EMC_B1_19); also elsewhere on the board
FLASH_CLK: U1.G14 (GPIO_SD_B2_07); also elsewhere on the board
FLASH_CS_N: U1.F17 (GPIO_SD_B2_06); also elsewhere on the board
FLASH_IO0: U1.F15 (GPIO_SD_B2_08); also elsewhere on the board
FLASH_IO1: U1.H15 (GPIO_SD_B2_09); also elsewhere on the board
FLASH_IO2: U1.H14 (GPIO_SD_B2_10); also elsewhere on the board
FLASH_IO3: U1.F16 (GPIO_SD_B2_11); also elsewhere on the board
G0: U1.J16 (GPIO_AD_34); also elsewhere on the board
G1: U1.K16 (GPIO_AD_32); also elsewhere on the board
G2: U1.H17 (GPIO_AD_33); also elsewhere on the board
G3: U1.M16 (GPIO_AD_18); also elsewhere on the board
G4: U1.M13 (GPIO_AD_04); also elsewhere on the board
G5: U1.R17 (GPIO_AD_10); also elsewhere on the board
G6: U1.R14 (GPIO_AD_01); also elsewhere on the board
G7: U1.P17 (GPIO_AD_12); also elsewhere on the board
G8: U1.T17 (GPIO_AD_07); also elsewhere on the board
G9: U1.P16 (GPIO_AD_11); also elsewhere on the board
G10: U1.P15 (GPIO_AD_03); also elsewhere on the board
G11: U1.M14 (GPIO_AD_15); also elsewhere on the board
GND: U1.T11 (TEST_MODE); also elsewhere on the board
I2C_INT_N: U1.D13 (GPIO_DISP_B1_01); also elsewhere on the board
I2C_SCL: U1.B6 (GPIO_DISP_B2_12); also elsewhere on the board
I2C_SCL1: U1.R15 (GPIO_AD_08); also elsewhere on the board
I2C_SDA: U1.A5 (GPIO_DISP_B2_13); also elsewhere on the board
I2C_SDA1: U1.R16 (GPIO_AD_09); also elsewhere on the board
LED: U1.U8 (GPIO_LPSR_08); also elsewhere on the board
POR_B: U1.T10 (POR_B); also elsewhere on the board
PWM0: U1.L17 (GPIO_AD_28); also elsewhere on the board
PWM1: U1.M17 (GPIO_AD_29); also elsewhere on the board
RTC_XTALI: U1.T13 (RTC_XTALI); also elsewhere on the board
RTC_XTALO: U1.U13 (RTC_XTALO); also elsewhere on the board
RX1: U1.E11 (GPIO_DISP_B1_03); also elsewhere on the board
RX2: U1.A6 (GPIO_DISP_B2_11); also elsewhere on the board
SAI4_MCLK: U1.N8 (GPIO_LPSR_05); also elsewhere on the board
SDIO_CLK: U1.D15 (GPIO_SD_B1_01); also elsewhere on the board
SDIO_CMD: U1.B16 (GPIO_SD_B1_00); also elsewhere on the board
SDIO_DATA0: U1.C15 (GPIO_SD_B1_02); also elsewhere on the board
SDIO_DATA1: U1.B17 (GPIO_SD_B1_03); also elsewhere on the board
SDIO_DATA2: U1.B15 (GPIO_SD_B1_04); also elsewhere on the board
SDIO_DATA3: U1.A16 (GPIO_SD_B1_05); also elsewhere on the board
SPI_CS_N: U1.M15 (GPIO_AD_25); also elsewhere on the board
SPI_SCK: U1.L13 (GPIO_AD_24); also elsewhere on the board
SPI_SDI: U1.N16 (GPIO_AD_27); also elsewhere on the board
SPI_SDO: U1.L14 (GPIO_AD_26); also elsewhere on the board
SWCLK: U1.T6 (GPIO_LPSR_14); also elsewhere on the board
SWDIO: U1.U7 (GPIO_LPSR_15); also elsewhere on the board
TX1: U1.D11 (GPIO_DISP_B1_02); also elsewhere on the board
TX2: U1.D9 (GPIO_DISP_B2_10); also elsewhere on the board
USBHOST_DN: U1.C16 (USB2_DN); also elsewhere on the board
USBHOST_DP: U1.C17 (USB2_DP); also elsewhere on the board
USB_DN: U1.E16 (USB1_DN); also elsewhere on the board
USB_DP: U1.E17 (USB1_DP); also elsewhere on the board
USB_VIN: U1.D17 (USB1_VBUS); also elsewhere on the board
V3V3_EN: U1.C11 (GPIO_DISP_B1_05); also elsewhere on the board
XTALI: U1.U16 (XTALI); also elsewhere on the board
XTALO: U1.T16 (XTALO); also elsewhere on the board

Notes on the sheet:
All I/O banks at 3.3 V. Unused pads float (pad keepers). BOOT_CFG pads only go to the straps on the Flash sheet.

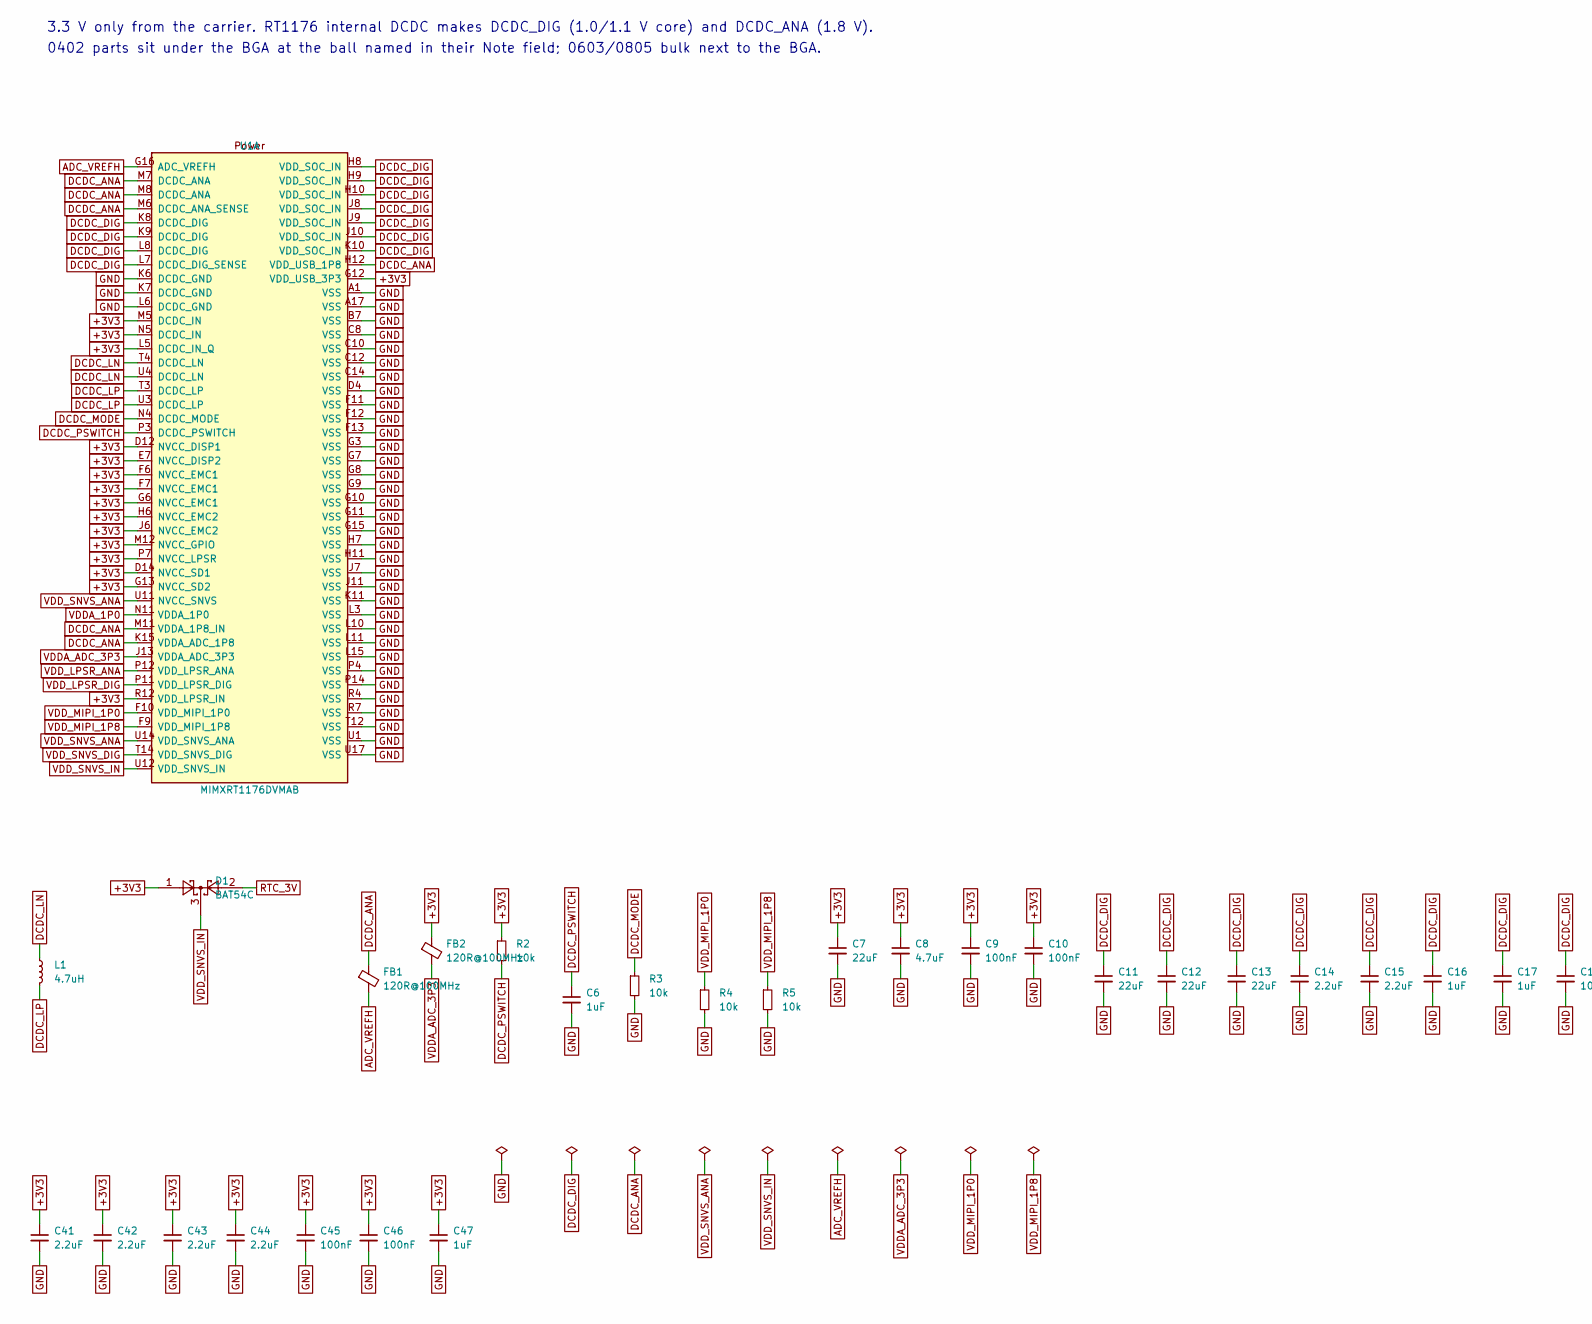
[picture p17: schematic power.kicad_sch, RT1176 MicroMod SOM: RT1176 power, part in row 1, column 1]

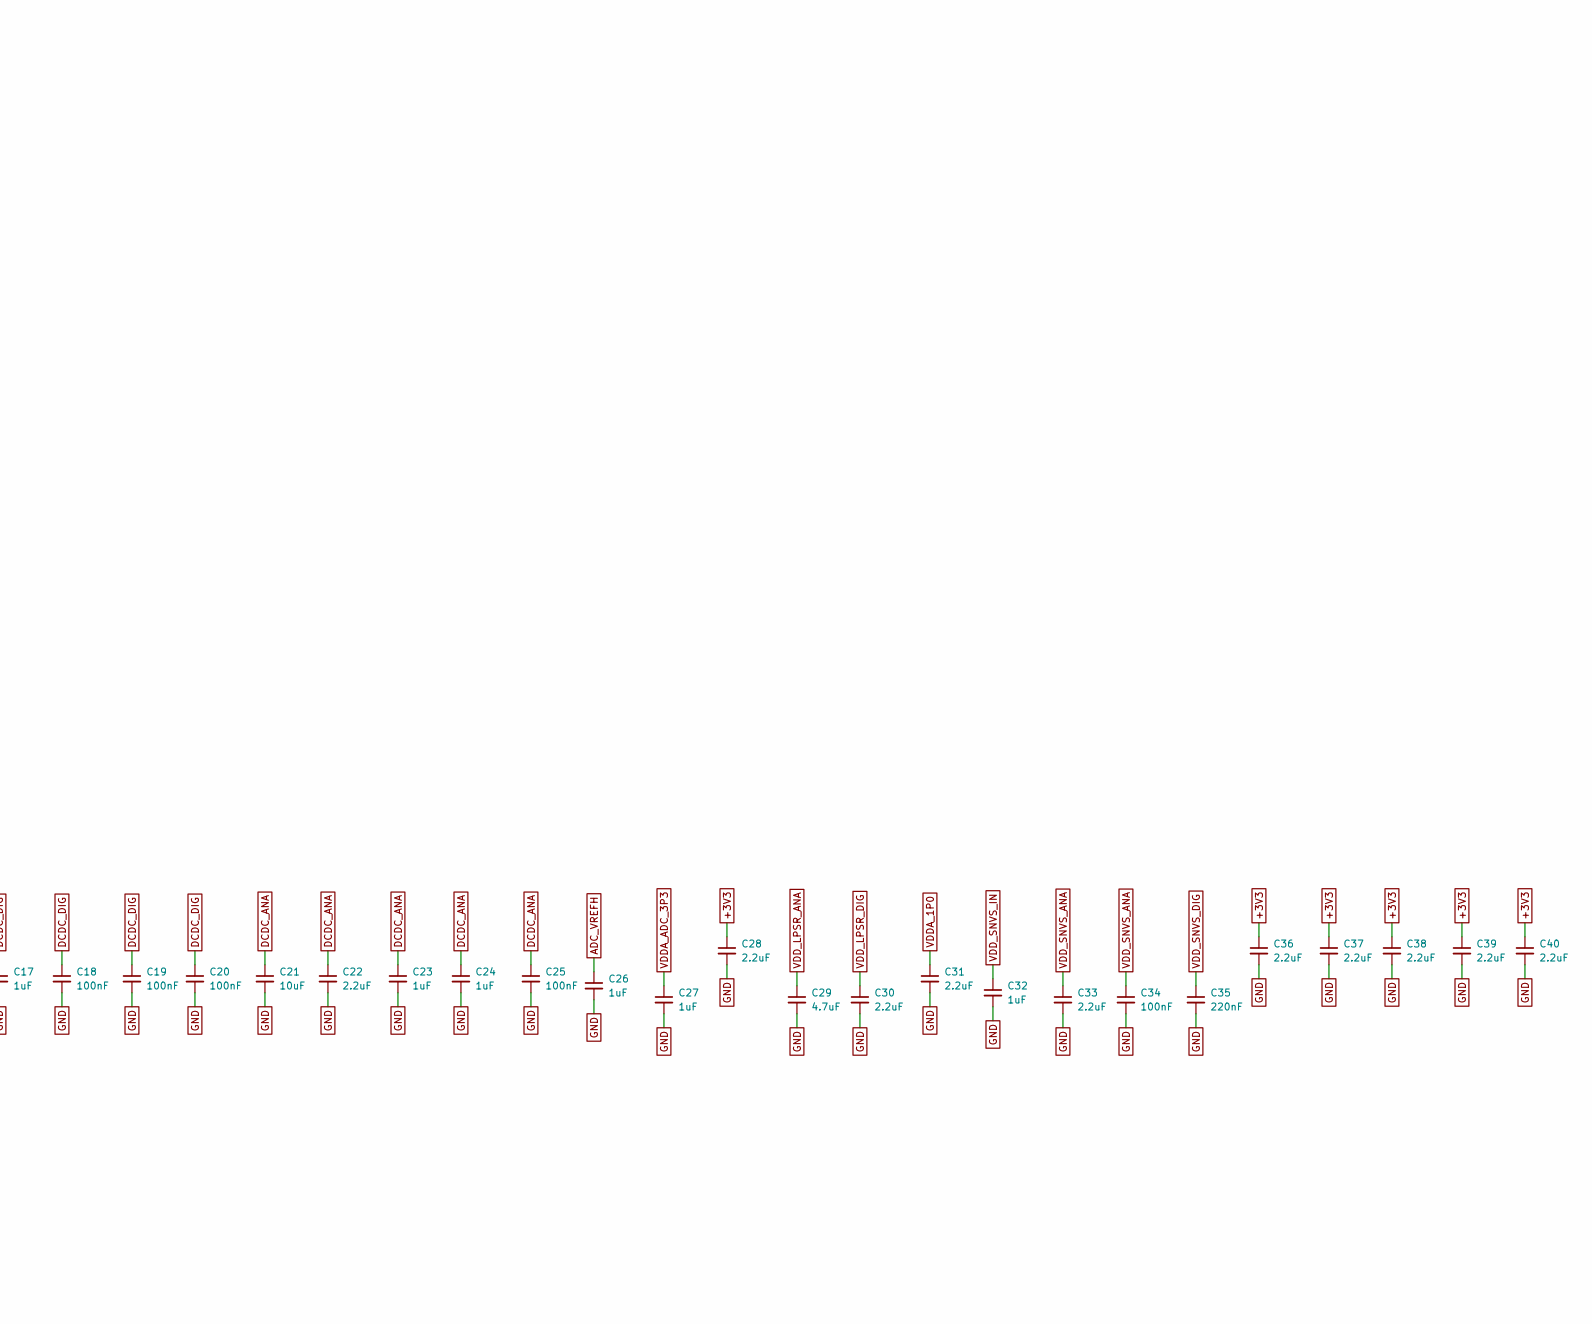
[picture p18: schematic power.kicad_sch, RT1176 MicroMod SOM: RT1176 power, part in row 1, column 2]

Parts:
C6, C16, C17, C23, C24, C26, C27, C32, C47: 1uF; C_0402_1005Metric
C7, C11, C12, C13: 22uF; C_0805_2012Metric
C8: 4.7uF; C_0603_1608Metric
C9, C10, C18, C19, C20, C25, C34, C45, C46: 100nF; C_0402_1005Metric
C14, C15, C22, C28, C30, C31, C33, C36, C37, C38, C39, C40, C41, C42, C43, C44: 2.2uF; C_0402_1005Metric
C21: 10uF; C_0603_1608Metric
C29: 4.7uF; C_0402_1005Metric
C35: 220nF; C_0402_1005Metric
D1: BAT54C; SOT-23; MPN BAT54C,215; LCSC C37704
FB1, FB2: 120R@100MHz; L_0603_1608Metric
L1: 4.7uH; L_Changjiang_FNR4030S; MPN SWPA4030S4R7MT; LCSC C57269
R2, R3, R4, R5: 10k; R_0402_1005Metric
U1: MIMXRT1176DVMAB; MAPBGA_14x14mm_Layout17x17_P0.8mm; MPN MIMXRT1176DVMAB

Connections:
+3V3: C7.1, C8.1, C9.1, C10.1, C28.1, C36.1, C37.1, C38.1, C39.1, C40.1, C41.1, C42.1, C43.1, C44.1, C45.1, C46.1, C47.1, D1.1, FB2.1, R2.1, U1.D12 (NVCC_DISP1), U1.D14 (NVCC_SD1), U1.E7 (NVCC_DISP2), U1.F6 (NVCC_EMC1), U1.F7 (NVCC_EMC1), U1.G6 (NVCC_EMC1), U1.G12 (VDD_USB_3P3), U1.G13 (NVCC_SD2), U1.H6 (NVCC_EMC2), U1.J6 (NVCC_EMC2), U1.L5 (DCDC_IN_Q), U1.M5 (DCDC_IN), U1.M12 (NVCC_GPIO), U1.N5 (DCDC_IN), U1.P7 (NVCC_LPSR), U1.R12 (VDD_LPSR_IN); also elsewhere on the board
ADC_VREFH: C26.1, FB1.2, U1.G16 (ADC_VREFH)
DCDC_ANA: C21.1, C22.1, C23.1, C24.1, C25.1, FB1.1, U1.H12 (VDD_USB_1P8), U1.K15 (VDDA_ADC_1P8), U1.M6 (DCDC_ANA_SENSE), U1.M7 (DCDC_ANA), U1.M8 (DCDC_ANA), U1.M11 (VDDA_1P8_IN)
DCDC_DIG: C11.1, C12.1, C13.1, C14.1, C15.1, C16.1, C17.1, C18.1, C19.1, C20.1, U1.H8 (VDD_SOC_IN), U1.H9 (VDD_SOC_IN), U1.H10 (VDD_SOC_IN), U1.J8 (VDD_SOC_IN), U1.J9 (VDD_SOC_IN), U1.J10 (VDD_SOC_IN), U1.K8 (DCDC_DIG), U1.K9 (DCDC_DIG), U1.K10 (VDD_SOC_IN), U1.L7 (DCDC_DIG_SENSE), U1.L8 (DCDC_DIG)
DCDC_LN: L1.1, U1.T4 (DCDC_LN), U1.U4 (DCDC_LN)
DCDC_LP: L1.2, U1.T3 (DCDC_LP), U1.U3 (DCDC_LP)
DCDC_MODE: R3.1, U1.N4 (DCDC_MODE)
DCDC_PSWITCH: C6.1, R2.2, U1.P3 (DCDC_PSWITCH)
GND: C6.2, C7.2, C8.2, C9.2, C10.2, C11.2, C12.2, C13.2, C14.2, C15.2, C16.2, C17.2, C18.2, C19.2, C20.2, C21.2, C22.2, C23.2, C24.2, C25.2, C26.2, C27.2, C28.2, C29.2, C30.2, C31.2, C32.2, C33.2, C34.2, C35.2, C36.2, C37.2, C38.2, C39.2, C40.2, C41.2, C42.2, C43.2, C44.2, C45.2, C46.2, C47.2, R3.2, R4.2, R5.2, U1.A1 (VSS), U1.A17 (VSS), U1.B7 (VSS), U1.C8 (VSS), U1.C10 (VSS), U1.C12 (VSS), U1.C14 (VSS), U1.D4 (VSS), U1.F11 (VSS), U1.F12 (VSS), U1.F13 (VSS), U1.G3 (VSS), U1.G7 (VSS), U1.G8 (VSS), U1.G9 (VSS), U1.G10 (VSS), U1.G11 (VSS), U1.G15 (VSS), U1.H7 (VSS), U1.H11 (VSS), U1.J7 (VSS), U1.J11 (VSS), U1.K6 (DCDC_GND), U1.K7 (DCDC_GND), U1.K11 (VSS), U1.L3 (VSS), U1.L6 (DCDC_GND), U1.L10 (VSS), U1.L11 (VSS), U1.L15 (VSS), U1.P4 (VSS), U1.P14 (VSS), U1.R4 (VSS), U1.R7 (VSS), U1.T12 (VSS), U1.U1 (VSS), U1.U17 (VSS); also elsewhere on the board
RTC_3V: D1.2; also elsewhere on the board
VDDA_1P0: C31.1, U1.N11 (VDDA_1P0)
VDDA_ADC_3P3: C27.1, FB2.2, U1.J13 (VDDA_ADC_3P3)
VDD_LPSR_ANA: C29.1, U1.P12 (VDD_LPSR_ANA)
VDD_LPSR_DIG: C30.1, U1.P11 (VDD_LPSR_DIG)
VDD_MIPI_1P0: R4.1, U1.F10 (VDD_MIPI_1P0)
VDD_MIPI_1P8: R5.1, U1.F9 (VDD_MIPI_1P8)
VDD_SNVS_ANA: C33.1, C34.1, U1.U11 (NVCC_SNVS), U1.U14 (VDD_SNVS_ANA)
VDD_SNVS_DIG: C35.1, U1.T14 (VDD_SNVS_DIG)
VDD_SNVS_IN: C32.1, D1.3, U1.U12 (VDD_SNVS_IN)

Notes on the sheet:
3.3 V only from the carrier. RT1176 internal DCDC makes DCDC_DIG (1.0/1.1 V core) and DCDC_ANA (1.8 V).
0402 parts sit under the BGA at the ball named in their Note field; 0603/0805 bulk next to the BGA.

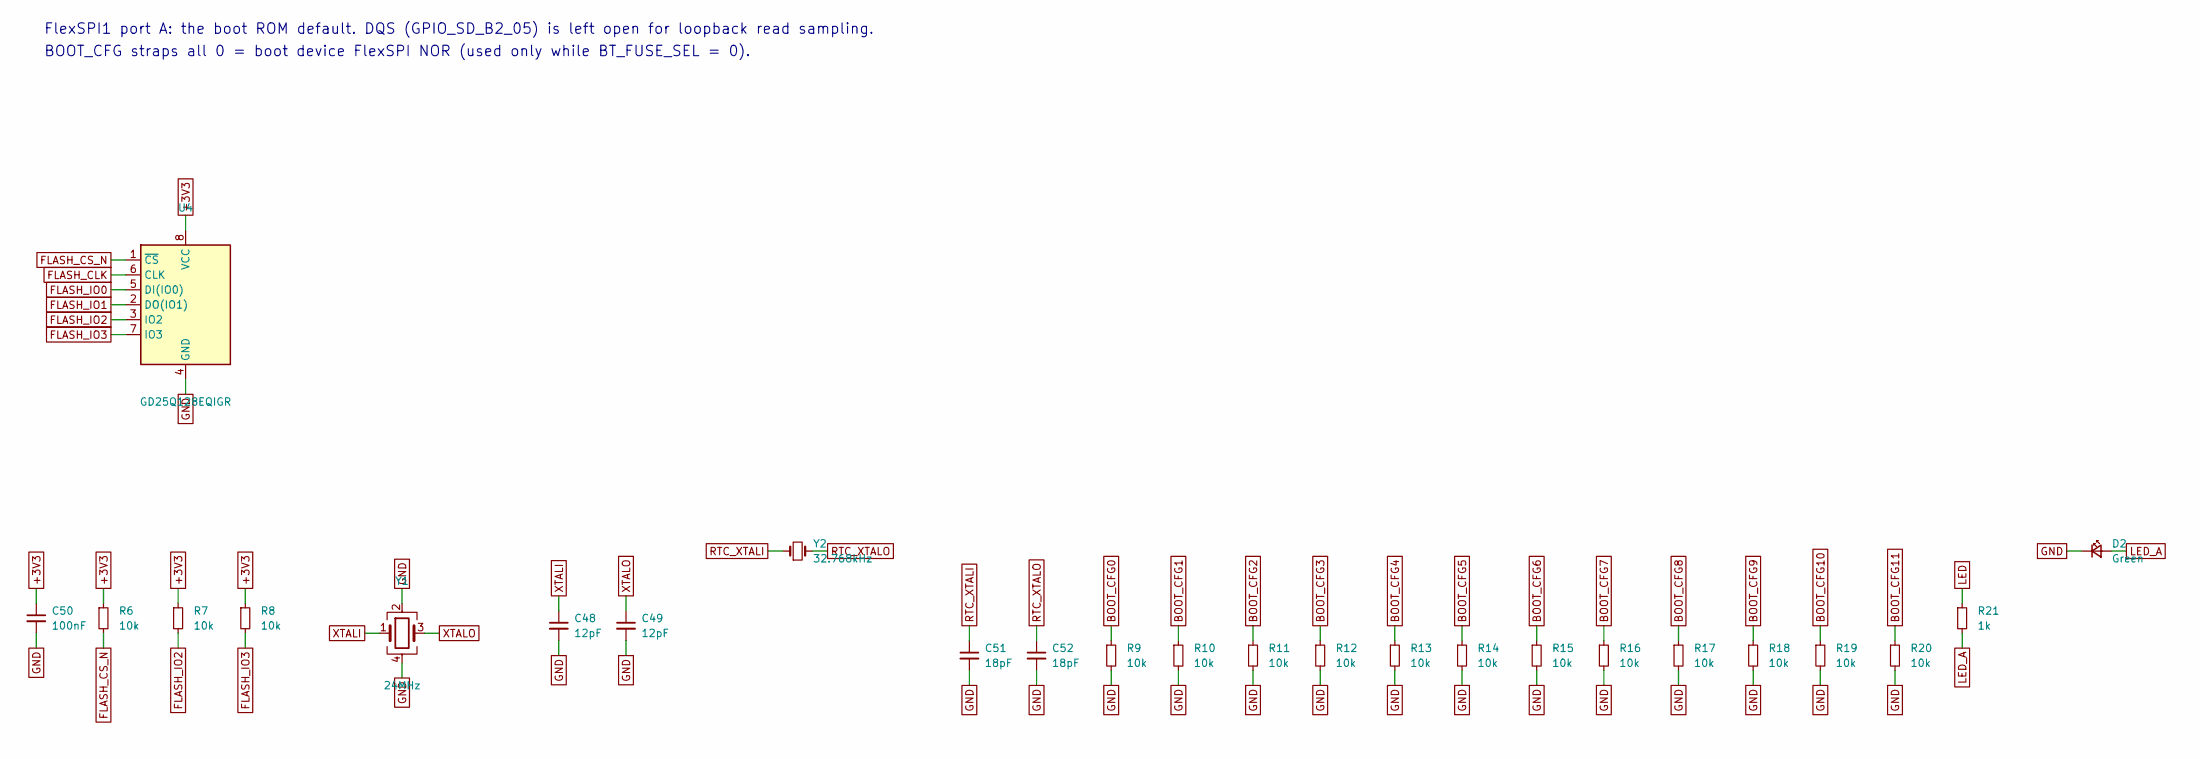
[picture p19: schematic mem.kicad_sch, RT1176 MicroMod SOM: Flash, clocks, boot straps, LED]

Parts:
C48, C49: 12pF; C_0402_1005Metric
C50: 100nF; C_0603_1608Metric
C51, C52: 18pF; C_0402_1005Metric
D2: Green; LED_0603_1608Metric
R6, R7, R8: 10k; R_0603_1608Metric
R9, R10, R11, R12, R13, R14, R15, R16, R17, R18, R19, R20: 10k; R_0402_1005Metric
R21: 1k; R_0603_1608Metric
U4: GD25Q128EQIGR; USON-8-1EP_4x4mm_P0.8mm_EP2.3x3mm_GigaDevice; MPN GD25Q128EQIGR
Y1: 24MHz; Crystal_SMD_2016-4Pin_2.0x1.6mm
Y2: 32.768kHz; Crystal_SMD_3215-2Pin_3.2x1.5mm; MPN Q13FC1350000400; LCSC C32346

Connections:
+3V3: C50.1, R6.1, R7.1, R8.1, U4.8 (VCC); also elsewhere on the board
BOOT_CFG0: R9.1; also elsewhere on the board
BOOT_CFG1: R10.1; also elsewhere on the board
BOOT_CFG2: R11.1; also elsewhere on the board
BOOT_CFG3: R12.1; also elsewhere on the board
BOOT_CFG4: R13.1; also elsewhere on the board
BOOT_CFG5: R14.1; also elsewhere on the board
BOOT_CFG6: R15.1; also elsewhere on the board
BOOT_CFG7: R16.1; also elsewhere on the board
BOOT_CFG8: R17.1; also elsewhere on the board
BOOT_CFG9: R18.1; also elsewhere on the board
BOOT_CFG10: R19.1; also elsewhere on the board
BOOT_CFG11: R20.1; also elsewhere on the board
FLASH_CLK: U4.6 (CLK); also elsewhere on the board
FLASH_CS_N: R6.2, U4.1 (~CS); also elsewhere on the board
FLASH_IO0: U4.5 (DI(IO0)); also elsewhere on the board
FLASH_IO1: U4.2 (DO(IO1)); also elsewhere on the board
FLASH_IO2: R7.2, U4.3 (IO2); also elsewhere on the board
FLASH_IO3: R8.2, U4.7 (IO3); also elsewhere on the board
GND: C48.2, C49.2, C50.2, C51.2, C52.2, D2.1 (K), R9.2, R10.2, R11.2, R12.2, R13.2, R14.2, R15.2, R16.2, R17.2, R18.2, R19.2, R20.2, U4.4 (GND), Y1.2, Y1.4; also elsewhere on the board
LED: R21.1; also elsewhere on the board
LED_A: D2.2 (A), R21.2
RTC_XTALI: C51.1, Y2.1; also elsewhere on the board
RTC_XTALO: C52.1, Y2.2; also elsewhere on the board
XTALI: C48.1, Y1.1; also elsewhere on the board
XTALO: C49.1, Y1.3; also elsewhere on the board

Notes on the sheet:
FlexSPI1 port A: the boot ROM default. DQS (GPIO_SD_B2_05) is left open for loopback read sampling.
BOOT_CFG straps all 0 = boot device FlexSPI NOR (used only while BT_FUSE_SEL = 0).

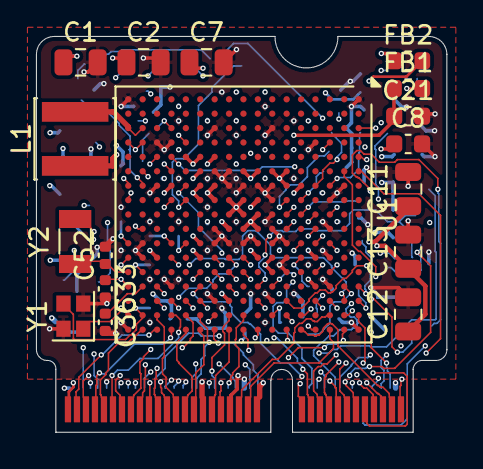
[picture p20: board rt1176-micromod-som.kicad_pcb from above]

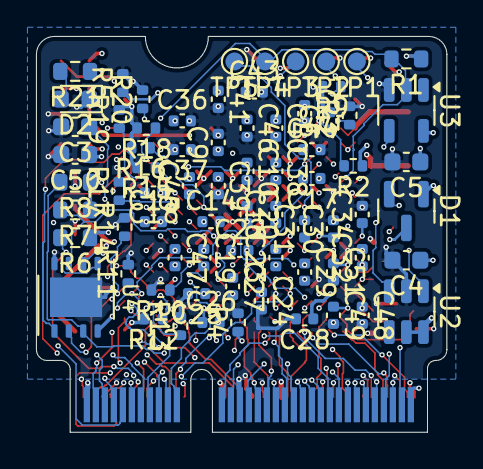
[picture p21: board rt1176-micromod-som.kicad_pcb from below]

Board: 6 copper layers, 22.8 x 22.0 mm, 90 parts (72 on the bottom side), 105 nets.
