markrlupton/rt1176-micromod-som/tools/pinmap.py

"""RT1176 MicroMod card: MicroMod pin -> RT1176 pad/function. Single source of truth for the pin map.
Each entry: mm_pin: (MicroMod name, Teensy pin/notes, RT1176 pad or special, function, note)
"""
PINMAP = {
    # --- power / system ---
    1:  ("GND", "", "GND", "GND", ""),
    2:  ("3.3V", "", "+3V3", "3.3 V in from carrier", "all I/O banks, DCDC_IN, LPSR_IN at 3.3 V"),
    3:  ("USB_D+", "USB", "USB1_DP", "USB OTG1 D+", "NXP ROM serial downloader runs here"),
    4:  ("3.3V_EN", "28", "GPIO_DISP_B1_05", "GPIO", "Teensy uses it as GPIO 28"),
    5:  ("USB_D-", "USB", "USB1_DN", "USB OTG1 D-", ""),
    6:  ("RESET#", "ON/OFF", "SUPERVISOR_MR", "reset (via supervisor to POR_B)", "Teensy: ONOFF. Here: real reset"),
    7:  ("GND", "", "GND", "GND", ""),
    8:  ("G11", "27/A13", "GPIO_AD_15", "GPIO / ADC1_CH4B", ""),
    9:  ("USB_VIN", "VUSB", "USB1_VBUS", "USB OTG1 VBUS sense", "5 V tolerant VBUS input"),
    10: ("D0", "4", "GPIO_EMC_B1_09", "GPIO / FLEXPWM2_PWM1_B", "carrier: PTT1_IN"),
    11: ("BOOT#", "PROG", "GPIO_LPSR_03", "BOOT_MODE1 (10k pull-up) + inverter to BOOT_MODE0", "held low at reset = BOOT_MODE 01, USB serial downloader"),
    12: ("I2C_SDA", "18/A4", "GPIO_DISP_B2_13", "LPI2C4_SDA", ""),
    13: ("RTS1", "(NC on Teensy)", "GPIO_LPSR_10", "SAI4_TX_SYNC", "AUD2_LRCLK (second SAI)"),
    14: ("I2C_SCL", "19/A5", "GPIO_DISP_B2_12", "LPI2C4_SCL", ""),
    15: ("CTS1", "(NC on Teensy)", "GPIO_LPSR_09", "SAI4_TX_DATA", "AUD2_OUT (second SAI)"),
    16: ("I2C_INT#", "29", "GPIO_DISP_B1_01", "GPIO", ""),
    17: ("TX1", "1", "GPIO_DISP_B1_02", "LPUART1_TX", ""),
    18: ("D1", "5", "GPIO_EMC_B1_19", "GPIO / FLEXPWM2_PWM3_A", "carrier: PTT2_IN"),
    19: ("RX1", "0", "GPIO_DISP_B1_03", "LPUART1_RX", ""),
    20: ("RX2", "16/A2", "GPIO_DISP_B2_11", "LPUART2_RX", ""),
    21: ("SWDCK", "(NC on Teensy)", "GPIO_LPSR_06", "SAI4_RX_DATA", "AUD2_IN (second SAI); SWD moved to card test pads"),
    22: ("TX2", "17/A3", "GPIO_DISP_B2_10", "LPUART2_TX", ""),
    23: ("SWDIO", "(NC on Teensy)", "GPIO_LPSR_04", "SAI4_TX_BCLK", "AUD2_BCLK (second SAI); SWD moved to card test pads"),
    32: ("PWM0", "3", "GPIO_AD_28", "FLEXPWM2_PWM2_A", "carrier: CODEC_RST"),
    33: ("GND", "", "GND", "GND", ""),
    34: ("A0", "14", "GPIO_AD_13", "GPIO / ADC1_CH3B", "carrier: IGN_SENSE"),
    35: ("USBHOST_D+", "USB2", "USB2_DP", "USB OTG2 D+", ""),
    36: ("GND", "", "GND", "GND", ""),
    37: ("USBHOST_D-", "USB2", "USB2_DN", "USB OTG2 D-", ""),
    38: ("A1", "15", "GPIO_AD_19", "GPIO / ADC2_CH0B", "carrier: AUX_SENSE"),
    39: ("GND", "", "GND", "GND", ""),
    40: ("G0", "40", "GPIO_AD_34", "GPIO", "carrier: AMP_MUTE"),
    41: ("CAN_RX", "30", "GPIO_AD_31", "CAN2_RX", "Teensy used CAN3; RT1176 CAN1-3 are all FD"),
    42: ("G1", "41", "GPIO_AD_32", "GPIO", ""),
    43: ("CAN_TX", "31", "GPIO_AD_30", "CAN2_TX", ""),
    44: ("G2", "42", "GPIO_AD_33", "GPIO", "carrier: ETH_RST"),
    45: ("GND", "", "GND", "GND", ""),
    46: ("G3", "43", "GPIO_AD_18", "GPIO", ""),
    47: ("PWM1", "2", "GPIO_AD_29", "FLEXPWM2_PWM2_B", "carrier: CAN_STB"),
    48: ("G4", "44", "GPIO_AD_04", "GPIO", ""),
    49: ("BATT_VIN/3", "22/A8", "GPIO_AD_16", "GPIO / ADC1_CH5A", "carrier: VIN_SENSE"),
    50: ("AUD_BCLK", "21", "GPIO_AD_22", "SAI1_TX_BCLK", "TDM bit clock"),
    51: ("I2C_SDA1", "25/A11", "GPIO_AD_09", "LPI2C1_SDA", ""),
    52: ("AUD_LRCLK", "20", "GPIO_AD_23", "SAI1_TX_SYNC", "TDM frame sync"),
    53: ("I2C_SCL1", "24/A10", "GPIO_AD_08", "LPI2C1_SCL", ""),
    54: ("AUD_IN", "8", "GPIO_AD_20", "SAI1_RX_DATA00", "RX in sync mode off TX clocks"),
    55: ("SPI_CS#", "10", "GPIO_AD_25", "LPSPI2_PCS0", ""),
    56: ("AUD_OUT", "7", "GPIO_AD_21", "SAI1_TX_DATA00", ""),
    57: ("SPI_SCK", "13", "GPIO_AD_24", "LPSPI2_SCK", ""),
    58: ("AUD_MCLK", "23", "GPIO_AD_17", "SAI1_MCLK", ""),
    59: ("SPI_SDO", "11", "GPIO_AD_26", "LPSPI2_SDO", ""),
    60: ("SDIO_CLK", "36", "GPIO_SD_B1_01", "USDHC1_CLK", "Teensy SPI1 alt not available on these pads"),
    61: ("SPI_SDI", "12", "GPIO_AD_27", "LPSPI2_SDI", ""),
    62: ("SDIO_CMD", "37", "GPIO_SD_B1_00", "USDHC1_CMD", ""),
    63: ("G10", "33", "GPIO_AD_03", "GPIO", "carrier: ETH_INT"),
    64: ("SDIO_DATA0", "35", "GPIO_SD_B1_02", "USDHC1_DATA0", ""),
    65: ("G9", "32", "GPIO_AD_11", "GPIO", "carrier: FP_GPIO2"),
    66: ("SDIO_DATA1", "34", "GPIO_SD_B1_03", "USDHC1_DATA1", ""),
    67: ("G8", "26/A12", "GPIO_AD_07", "GPIO / ADC1_CH0B", "carrier: FP_GPIO1"),
    68: ("SDIO_DATA2", "39", "GPIO_SD_B1_04", "USDHC1_DATA2", ""),
    69: ("G7", "9", "GPIO_AD_12", "GPIO", "carrier: FP_BOOT"),
    70: ("SDIO_DATA3", "38", "GPIO_SD_B1_05", "USDHC1_DATA3", ""),
    71: ("G6", "6", "GPIO_AD_01", "GPIO", "carrier: FP_NRST (drive open-drain)"),
    72: ("RTC_3V", "VBAT", "VDD_SNVS_IN", "RTC backup supply (diode-OR with 3.3 V)", ""),
    73: ("G5", "45", "GPIO_AD_10", "GPIO", "carrier: ETH_CS"),
    74: ("3.3V", "", "+3V3", "3.3 V in", ""),
    75: ("GND", "", "GND", "GND", ""),
}

# card-internal pad uses (not on the edge connector)
INTERNAL = {
    "GPIO_SD_B2_05": "FLEXSPI1_A_DQS (leave open: loopback read strobe)",
    "GPIO_SD_B2_06": "FLEXSPI1_A_SS0_B -> flash CS#",
    "GPIO_SD_B2_07": "FLEXSPI1_A_SCLK -> flash CLK",
    "GPIO_SD_B2_08": "FLEXSPI1_A_DATA00 -> flash IO0",
    "GPIO_SD_B2_09": "FLEXSPI1_A_DATA01 -> flash IO1",
    "GPIO_SD_B2_10": "FLEXSPI1_A_DATA02 -> flash IO2",
    "GPIO_SD_B2_11": "FLEXSPI1_A_DATA03 -> flash IO3",
    "GPIO_LPSR_02": "BOOT_MODE0 = inverted BOOT# (SN74LVC1G04)",
    "GPIO_LPSR_08": "status LED (active high, 0603)",
    "GPIO_LPSR_14": "SWD clock -> test pad",
    "GPIO_LPSR_15": "SWD data -> test pad",
    "GPIO_LPSR_05": "SAI4_MCLK -> test pad (optional, not on the edge)",
    **{f"GPIO_DISP_B1_{i:02d}": "BOOT_CFG strap (10k pull-down)" for i in range(6, 12)},
    **{f"GPIO_DISP_B2_{i:02d}": "BOOT_CFG strap (10k pull-down)" for i in range(0, 6)},
}

FORBIDDEN_FOR_EDGE = (
    [f"GPIO_SD_B2_{i:02d}" for i in range(0, 12)]            # flash bank (00-04 not in symbol)
    + [f"GPIO_DISP_B1_{i:02d}" for i in range(6, 12)]         # BOOT_CFG straps
    + [f"GPIO_DISP_B2_{i:02d}" for i in range(0, 6)]
    + ["GPIO_LPSR_02", "GPIO_LPSR_08"]
    + [f"GPIO_SNVS_{i:02d}" for i in range(10)]               # 1.75 V SNVS domain
)
