markrlupton/rt1176-micromod-som/(commit log)

2026-11-06 Stage 1: pin map, floorplan and design notes
    Claude-Session: https://claude.ai/code/session_01BQhBpUBZK32B7f8Y273f43
2026-11-06 Fix BGA orientation, re-optimize pads, add SAI4 on pins 13/15/21/23
    The v0 floorplan had the RT1176 ball map transposed (bottom view). v1 uses the
    standard top view rotated 90 degrees clockwise; tools/optimize_pins.py re-picks
    every peripheral instance and pad for short ball-to-finger routes.
    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
    [floorplan.py, optimize_pins.py, pinmap.py]
2026-11-06 Decide 16 MB GD25Q128EQIGR and 22.8 mm card width
    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
2026-11-06 Stage 2: library, generated schematic and netlist checks
    - tools/libgen.py: RT1176 symbol (6 units from the ball map), MicroMod card symbol, edge-finger footprint
    - tools/schgen.py: 4-sheet KiCad 7 schematic from one parts/nets table
    - tools/schcheck.py: netlist vs design table, pin map and NXP rail rules (PASS)
    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
    [edge.kicad_sch, mcu.kicad_sch, mem.kicad_sch, power.kicad_sch, rt1176-micromod-som.kicad_sch]
2026-11-06 GD25Q128EQIGR USON-8 4x4 footprint from the GigaDevice datasheet
    Lands per DS-00480 rev 1.4 section 10.3; EP tied to GND. Note QE defaults to 0.
    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
    [mem.kicad_sch]
2026-11-06 Stage 3 WIP: placement, BGA fan-out, under-BGA 0402 placer, planes and Freerouting flow
    - pcbgen.py: band packing, tightened courtyards, proper pad-to-via clearance, top-side fallback for 0402s
    - route.py: In1/In4 GND, In3 +3V3 with DCDC_DIG island, DSN patch (power classes, edge boundary), SES importer
    - drc.py: DRC through the pcbnew API (KiCad 7 CLI has none); render.sh: layer renders
    - DESIGN.md: layout section; L1 land pattern verified against Sunlord SWPA4030S
    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
    [edge.kicad_sch, mem.kicad_sch, power.kicad_sch, rt1176-micromod-som-placed.kicad_pcb, rt1176-micromod-som.kicad_pcb]
2026-11-07 route.py: 4 signal layers (F, In2, In3, B); In1 GND, In4 +3V3 with DCDC_DIG island
    The 3-signal-layer route left ~25 nets unrouted.
    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
2026-11-07 Board: 3-signal-layer autoroute result (incomplete, superseded by the 4-layer run in progress)
    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
    [rt1176-micromod-som.kicad_pcb]
2026-11-07 Fan-out: 0.3/0.15 vias (JLC 6-layer min), no dogbones on outer-two-ring signal balls
    The 4-signal-layer route still left ~30 nets; smaller vias open two-track channels
    and the outer rings now escape straight from the pads on F.Cu.
    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
    [rt1176-micromod-som-placed.kicad_pcb]
2026-11-07 Board: re-placed with 0.3/0.15 vias (unrouted; route in progress)
    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
    [rt1176-micromod-som.kicad_pcb]
2026-11-07 Route r3: 16 nets left (down from ~30); hole clearance 0.17 mm; route.py --continue
    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
    [rt1176-micromod-som.kicad_pcb]
2026-11-07 Board: Freerouting r4 result (16 open connections; cleanup router running)
    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
    [rt1176-micromod-som.kicad_pcb]
2026-11-07 0.09/0.09 mm trace/space (JLC multilayer min); keep the finger escape band clear of routed 0402s
    The rip-up router oscillated between 10 and 24 open connections over 45 rounds; the
    congestion is the ~3 mm band between the BGA and the fingers, so give it more room.
    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
    [rt1176-micromod-som-placed.kicad_pcb, rt1176-micromod-som.kicad_pcb]
2026-11-07 Route r5 (0.09/0.09): 18 nets open, otherwise DRC-clean; restate board minimums in route.py
    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
    [rt1176-micromod-som.kicad_pcb]
2026-11-13 Layout fully routed: negotiated-congestion router (tools/nroute), 0 unconnected, 0 clearance errors
    - tools/nroute: prep.py (fixed copper -> 0.05 mm grid), nroute.cpp (PathFinder-style router, 4 signal
    layers, fat-wire spacing model, plane stubs, hard-mode finish), emit.py (tracks/vias + cleanup), diag.py
    - power rails keep their tracks from the last Freerouting pass (docs/layout/power-rails.kicad_pcb)
    - project files: default net class 0.09/0.09 mm, 0.3/0.15 mm vias
    - docs: layout section, regenerate steps, open items (USB pair, crystal traces, +3V3 finger stubs, pours)
    - layer renders in docs/layout
    Claude-Session: https://claude.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
    [power-rails.kicad_pcb, rt1176-micromod-som.kicad_pcb]
2026-11-13 Layout tidy: USB and crystal nets routed first and frozen, wider plane stubs, GND pours
    - nroute: critical nets (CRIT=...) negotiate on the empty board with expensive vias, then freeze;
    +3V3 finger stubs reserve room for a 0.25 mm track
    - emit: widen plane stubs as far as DRC allows; GND fill on F, In2, In3, B
    - lengths.py; DESIGN.md table of timing-sensitive nets
    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
    [rt1176-micromod-som.kicad_pcb]
2026-11-13 C52 (RTC_XTALO load cap) to the top side beside Y2; RTC_XTALO now 1.5 mm with no via
    - tools/place_tweaks.py: hand placement fixes on top of pcbgen (C52 to top, Y2 0.1 mm left)
    - pcbgen: crystal load caps pick free spots first
    - emit: clean up loose GND/+3V3 stubs left by moved parts
    - docs: placement-of-record note, updated net table
    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
    [rt1176-micromod-som-placed.kicad_pcb, rt1176-micromod-som.kicad_pcb]
2026-11-13 Stage 4: JLC fab files, BOM/CPL with LCSC numbers, assembly drawings, hand-build stencil and guide
    - tools/fab.py: Gerbers + Excellon (fab/rt1176-micromod-som-gerbers.zip), bom-jlc.csv, cpl-jlc.csv,
    assembly-top/bottom.pdf, stencil-hand/ (top paste without BGA apertures), drc.txt; refuses to run on a
    board with DRC errors or unconnected pads
    - docs/FAB_NOTES.md: JLC order settings (6L 0.8 mm, 0.15/0.3 vias, epoxy-filled capped vias, ENIG, bevelled
    gold fingers), assembly and part notes
    - docs/HAND_BUILD.md: build order, reflow profiles, first power-up, parts by side (generated)
    Claude-Session: https://claude.ai/code/session_01BQh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
    [bom-jlc.csv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]
2026-11-14 Distributor BOM (Octopart/Mouser/DigiKey/Newark): fab/bom-distributors.csv, tools/bom_dist.py
    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
    [bom-distributors.csv]
2026-11-14 Pre-order review fixes: R1 4.7k, SNVS caps to the top side out of the M.2 keep-out, mask expansion 0.05
    - R1 (BOOT# pull-up) 10k -> 4.7k: BOOT_MODE pins have ~35k internal pull-downs (NXP hardware guide)
    - C33/C35 (VDD_SNVS_ANA/DIG caps) were 4.5 mm from the finger edge on the bottom, inside the M.2 5.2 mm
    bottom keep-out; now on the top side beside balls U14/T14 (place_tweaks.py); nets routed by nroute
    - solder mask expansion 0.05 mm; nroute: HOLE_CLR / TV2 / NROUTE_DIR knobs
    - board re-routed: 0 unconnected, 0 clearance errors
    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
    [edge.kicad_sch, rt1176-micromod-som-placed.kicad_pcb, rt1176-micromod-som.kicad_pcb]
